SoC-Labs/MegaSoC-Project/docs/src/fpga_build.rst

*********************
FPGA Flow
*********************
