SoC-Labs/MegaSoC-Project/fpga/targets/arm_mps4/fpga_pinmap.xdc

# -----------------------------------------------------------------------------
# Purpose : Main timing constraints and pin list for MPS3
# -----------------------------------------------------------------------------

####################################################################################
# Pin Assigment
####################################################################################

set_property IOSTANDARD LVCMOS18 [get_ports AUD_BCKAD_R] 
set_property PACKAGE_PIN BB22 [get_ports AUD_BCKAD_R] 
set_property IOSTANDARD LVCMOS18 [get_ports AUD_BCKDA_R] 
set_property PACKAGE_PIN BA24 [get_ports AUD_BCKDA_R] 
set_property IOSTANDARD LVCMOS18 [get_ports AUD_DIN[1]] 
set_property PACKAGE_PIN BA25 [get_ports AUD_DIN[1]] 
set_property IOSTANDARD LVCMOS18 [get_ports AUD_DIN[2]] 
set_property PACKAGE_PIN BD21 [get_ports AUD_DIN[2]] 
set_property IOSTANDARD LVCMOS18 [get_ports AUD_DIN[3]] 
set_property PACKAGE_PIN BC21 [get_ports AUD_DIN[3]] 
set_property IOSTANDARD LVCMOS18 [get_ports AUD_DIN[4]] 
set_property PACKAGE_PIN BB23 [get_ports AUD_DIN[4]] 
set_property IOSTANDARD LVCMOS18 [get_ports AUD_DOUT[1]] 
set_property PACKAGE_PIN BB24 [get_ports AUD_DOUT[1]] 
set_property IOSTANDARD LVCMOS18 [get_ports AUD_DOUT[2]] 
set_property PACKAGE_PIN BF22 [get_ports AUD_DOUT[2]] 
set_property IOSTANDARD LVCMOS18 [get_ports AUD_DOUT[3]] 
set_property PACKAGE_PIN BE22 [get_ports AUD_DOUT[3]] 
set_property IOSTANDARD LVCMOS18 [get_ports AUD_LRCKAD_R] 
set_property PACKAGE_PIN BE23 [get_ports AUD_LRCKAD_R] 
set_property IOSTANDARD LVCMOS18 [get_ports AUD_LRCKDA_R] 
set_property PACKAGE_PIN BD23 [get_ports AUD_LRCKDA_R] 
set_property IOSTANDARD LVCMOS18 [get_ports AUD_RST] 
set_property PACKAGE_PIN BD22 [get_ports AUD_RST] 
set_property IOSTANDARD LVCMOS18 [get_ports AUD_SCKI_R] 
set_property PACKAGE_PIN BC23 [get_ports AUD_SCKI_R] 
set_property IOSTANDARD LVCMOS18 [get_ports AUD_SCL] 
set_property PACKAGE_PIN BF24 [get_ports AUD_SCL] 
set_property IOSTANDARD LVCMOS18 [get_ports AUD_SDA] 
set_property PACKAGE_PIN BE24 [get_ports AUD_SDA] 
set_property IOSTANDARD DIFF_HSTL_I_18  [get_ports B2B_CLKN[0]] 
set_property PACKAGE_PIN AN41 [get_ports B2B_CLKN[0]] 
set_property IOSTANDARD DIFF_HSTL_I_18  [get_ports B2B_CLKN[1]] 
set_property PACKAGE_PIN AK39 [get_ports B2B_CLKN[1]] 
set_property IOSTANDARD DIFF_HSTL_I_18  [get_ports B2B_CLKN[2]] 
set_property PACKAGE_PIN AF39 [get_ports B2B_CLKN[2]] 
set_property IOSTANDARD DIFF_HSTL_I_18  [get_ports B2B_CLKN[3]] 
set_property PACKAGE_PIN AB39 [get_ports B2B_CLKN[3]] 
set_property IOSTANDARD DIFF_HSTL_I_18  [get_ports B2B_CLKN[4]] 
set_property PACKAGE_PIN V39 [get_ports B2B_CLKN[4]] 
set_property IOSTANDARD DIFF_HSTL_I_18  [get_ports B2B_CLKN[5]] 
set_property PACKAGE_PIN R41 [get_ports B2B_CLKN[5]] 
set_property IOSTANDARD DIFF_HSTL_I_18  [get_ports B2B_CLKN[6]] 
set_property PACKAGE_PIN AC8 [get_ports B2B_CLKN[6]] 
set_property IOSTANDARD DIFF_HSTL_I_18  [get_ports B2B_CLKN[7]] 
set_property PACKAGE_PIN R8 [get_ports B2B_CLKN[7]] 
set_property IOSTANDARD DIFF_HSTL_I_18  [get_ports B2B_CLKN[8]] 
set_property PACKAGE_PIN L8 [get_ports B2B_CLKN[8]] 
set_property IOSTANDARD DIFF_HSTL_I_18  [get_ports B2B_CLKN[9]] 
set_property PACKAGE_PIN AE8 [get_ports B2B_CLKN[9]] 
set_property IOSTANDARD DIFF_HSTL_I_18  [get_ports B2B_CLKP[0]] 
set_property PACKAGE_PIN AN40 [get_ports B2B_CLKP[0]] 
set_property IOSTANDARD DIFF_HSTL_I_18  [get_ports B2B_CLKP[1]] 
set_property PACKAGE_PIN AK38 [get_ports B2B_CLKP[1]] 
set_property IOSTANDARD DIFF_HSTL_I_18  [get_ports B2B_CLKP[2]] 
set_property PACKAGE_PIN AF38 [get_ports B2B_CLKP[2]] 
set_property IOSTANDARD DIFF_HSTL_I_18  [get_ports B2B_CLKP[3]] 
set_property PACKAGE_PIN AB38 [get_ports B2B_CLKP[3]] 
set_property IOSTANDARD DIFF_HSTL_I_18  [get_ports B2B_CLKP[4]] 
set_property PACKAGE_PIN V38 [get_ports B2B_CLKP[4]] 
set_property IOSTANDARD DIFF_HSTL_I_18  [get_ports B2B_CLKP[5]] 
set_property PACKAGE_PIN R40 [get_ports B2B_CLKP[5]] 
set_property IOSTANDARD DIFF_HSTL_I_18  [get_ports B2B_CLKP[6]] 
set_property PACKAGE_PIN AC9 [get_ports B2B_CLKP[6]] 
set_property IOSTANDARD DIFF_HSTL_I_18  [get_ports B2B_CLKP[7]] 
set_property PACKAGE_PIN R9 [get_ports B2B_CLKP[7]] 
set_property IOSTANDARD DIFF_HSTL_I_18  [get_ports B2B_CLKP[8]] 
set_property PACKAGE_PIN L9 [get_ports B2B_CLKP[8]] 
set_property IOSTANDARD DIFF_HSTL_I_18  [get_ports B2B_CLKP[9]] 
set_property PACKAGE_PIN AE9 [get_ports B2B_CLKP[9]] 
set_property IOSTANDARD LVCMOS18 [get_ports CB_nPOR] 
set_property PACKAGE_PIN AJ13 [get_ports CB_nPOR] 
set_property IOSTANDARD LVCMOS18 [get_ports CB_nRST] 
set_property PACKAGE_PIN AL12 [get_ports CB_nRST] 
set_property IOSTANDARD LVCMOS18 [get_ports CB_RSVD_F[0]] 
set_property PACKAGE_PIN AL32 [get_ports CB_RSVD_F[0]] 
set_property IOSTANDARD LVCMOS18 [get_ports CB_RSVD_F[1]] 
set_property PACKAGE_PIN AL35 [get_ports CB_RSVD_F[1]] 
set_property IOSTANDARD LVCMOS18 [get_ports CB_RSVD_F[2]] 
set_property PACKAGE_PIN AL34 [get_ports CB_RSVD_F[2]] 
set_property IOSTANDARD LVCMOS18 [get_ports CB_RUN] 
set_property PACKAGE_PIN AK12 [get_ports CB_RUN] 
set_property IOSTANDARD LVCMOS18 [get_ports CFG_CLK] 
set_property PACKAGE_PIN G18 [get_ports CFG_CLK] 
set_property IOSTANDARD LVCMOS18 [get_ports CFG_DATAIN] 
set_property PACKAGE_PIN D20 [get_ports CFG_DATAIN] 
set_property IOSTANDARD LVCMOS18 [get_ports CFG_DATAOUT] 
set_property PACKAGE_PIN D19 [get_ports CFG_DATAOUT] 
set_property IOSTANDARD LVCMOS18 [get_ports CFG_LOAD] 
set_property PACKAGE_PIN D17 [get_ports CFG_LOAD] 
set_property IOSTANDARD LVCMOS18 [get_ports CFG_nRST] 
set_property PACKAGE_PIN D16 [get_ports CFG_nRST] 
set_property IOSTANDARD LVCMOS18 [get_ports CFG_WnR] 
set_property PACKAGE_PIN C20 [get_ports CFG_WnR] 
set_property IOSTANDARD LVDS [get_ports CLK_BIDIR_R_N[2]] 
set_property PACKAGE_PIN F31 [get_ports CLK_BIDIR_R_N[2]] 
set_property IOSTANDARD LVDS [get_ports CLK_BIDIR_R_N[3]] 
set_property PACKAGE_PIN H30 [get_ports CLK_BIDIR_R_N[3]] 
set_property IOSTANDARD LVDS [get_ports CLK_BIDIR_R_P[2]] 
set_property PACKAGE_PIN G31 [get_ports CLK_BIDIR_R_P[2]] 
set_property IOSTANDARD LVDS [get_ports CLK_BIDIR_R_P[3]] 
set_property PACKAGE_PIN H29 [get_ports CLK_BIDIR_R_P[3]] 
set_property IOSTANDARD LVDS [get_ports CLK_M2C_N[0]] 
set_property PACKAGE_PIN F30 [get_ports CLK_M2C_N[0]] 
set_property IOSTANDARD LVDS [get_ports CLK_M2C_N[1]] 
set_property PACKAGE_PIN P32 [get_ports CLK_M2C_N[1]] 
set_property IOSTANDARD LVDS [get_ports CLK_M2C_P[0]] 
set_property PACKAGE_PIN G30 [get_ports CLK_M2C_P[0]] 
set_property IOSTANDARD LVDS [get_ports CLK_M2C_P[1]] 
set_property PACKAGE_PIN R32 [get_ports CLK_M2C_P[1]] 
set_property IOSTANDARD LVCMOS18 [get_ports CS_nDET] 
set_property PACKAGE_PIN AK15 [get_ports CS_nDET] 
set_property IOSTANDARD LVCMOS18 [get_ports CS_nSRST] 
set_property PACKAGE_PIN AM14 [get_ports CS_nSRST] 
set_property IOSTANDARD LVCMOS18 [get_ports CS_nTRST] 
set_property PACKAGE_PIN AL14 [get_ports CS_nTRST] 
set_property IOSTANDARD LVCMOS18 [get_ports CS_T_CLKA_R] 
set_property PACKAGE_PIN AR15 [get_ports CS_T_CLKA_R] 
set_property IOSTANDARD LVCMOS18 [get_ports CS_T_CLKB_R] 
set_property PACKAGE_PIN AP15 [get_ports CS_T_CLKB_R] 
set_property IOSTANDARD LVCMOS18 [get_ports CS_T_CTL] 
set_property PACKAGE_PIN AN15 [get_ports CS_T_CTL] 
set_property IOSTANDARD LVCMOS18 [get_ports CS_T_D[0]] 
set_property PACKAGE_PIN AP16 [get_ports CS_T_D[0]] 
set_property IOSTANDARD LVCMOS18 [get_ports CS_T_D[1]] 
set_property PACKAGE_PIN AN16 [get_ports CS_T_D[1]] 
set_property IOSTANDARD LVCMOS18 [get_ports CS_T_D[10]] 
set_property PACKAGE_PIN AW16 [get_ports CS_T_D[10]] 
set_property IOSTANDARD LVCMOS18 [get_ports CS_T_D[11]] 
set_property PACKAGE_PIN AM16 [get_ports CS_T_D[11]] 
set_property IOSTANDARD LVCMOS18 [get_ports CS_T_D[12]] 
set_property PACKAGE_PIN AY12 [get_ports CS_T_D[12]] 
set_property IOSTANDARD LVCMOS18 [get_ports CS_T_D[13]] 
set_property PACKAGE_PIN AU13 [get_ports CS_T_D[13]] 
set_property IOSTANDARD LVCMOS18 [get_ports CS_T_D[14]] 
set_property PACKAGE_PIN AU14 [get_ports CS_T_D[14]] 
set_property IOSTANDARD LVCMOS18 [get_ports CS_T_D[15]] 
set_property PACKAGE_PIN AY14 [get_ports CS_T_D[15]] 
set_property IOSTANDARD LVCMOS18 [get_ports CS_T_D[16]] 
set_property PACKAGE_PIN AY15 [get_ports CS_T_D[16]] 
set_property IOSTANDARD LVCMOS18 [get_ports CS_T_D[17]] 
set_property PACKAGE_PIN AW15 [get_ports CS_T_D[17]] 
set_property IOSTANDARD LVCMOS18 [get_ports CS_T_D[18]] 
set_property PACKAGE_PIN AV15 [get_ports CS_T_D[18]] 
set_property IOSTANDARD LVCMOS18 [get_ports CS_T_D[19]] 
set_property PACKAGE_PIN AV16 [get_ports CS_T_D[19]] 
set_property IOSTANDARD LVCMOS18 [get_ports CS_T_D[2]] 
set_property PACKAGE_PIN AR12 [get_ports CS_T_D[2]] 
set_property IOSTANDARD LVCMOS18 [get_ports CS_T_D[20]] 
set_property PACKAGE_PIN AU16 [get_ports CS_T_D[20]] 
set_property IOSTANDARD LVCMOS18 [get_ports CS_T_D[21]] 
set_property PACKAGE_PIN AT15 [get_ports CS_T_D[21]] 
set_property IOSTANDARD LVCMOS18 [get_ports CS_T_D[22]] 
set_property PACKAGE_PIN AT16 [get_ports CS_T_D[22]] 
set_property IOSTANDARD LVCMOS18 [get_ports CS_T_D[23]] 
set_property PACKAGE_PIN AV13 [get_ports CS_T_D[23]] 
set_property IOSTANDARD LVCMOS18 [get_ports CS_T_D[24]] 
set_property PACKAGE_PIN AV11 [get_ports CS_T_D[24]] 
set_property IOSTANDARD LVCMOS18 [get_ports CS_T_D[25]] 
set_property PACKAGE_PIN AU11 [get_ports CS_T_D[25]] 
set_property IOSTANDARD LVCMOS18 [get_ports CS_T_D[26]] 
set_property PACKAGE_PIN AY13 [get_ports CS_T_D[26]] 
set_property IOSTANDARD LVCMOS18 [get_ports CS_T_D[27]] 
set_property PACKAGE_PIN AW13 [get_ports CS_T_D[27]] 
set_property IOSTANDARD LVCMOS18 [get_ports CS_T_D[28]] 
set_property PACKAGE_PIN AW10 [get_ports CS_T_D[28]] 
set_property IOSTANDARD LVCMOS18 [get_ports CS_T_D[29]] 
set_property PACKAGE_PIN AV10 [get_ports CS_T_D[29]] 
set_property IOSTANDARD LVCMOS18 [get_ports CS_T_D[3]] 
set_property PACKAGE_PIN AP12 [get_ports CS_T_D[3]] 
set_property IOSTANDARD LVCMOS18 [get_ports CS_T_D[30]] 
set_property PACKAGE_PIN AY10 [get_ports CS_T_D[30]] 
set_property IOSTANDARD LVCMOS18 [get_ports CS_T_D[31]] 
set_property PACKAGE_PIN AW11 [get_ports CS_T_D[31]] 
set_property IOSTANDARD LVCMOS18 [get_ports CS_T_D[4]] 
set_property PACKAGE_PIN AN13 [get_ports CS_T_D[4]] 
set_property IOSTANDARD LVCMOS18 [get_ports CS_T_D[5]] 
set_property PACKAGE_PIN AN14 [get_ports CS_T_D[5]] 
set_property IOSTANDARD LVCMOS18 [get_ports CS_T_D[6]] 
set_property PACKAGE_PIN AR13 [get_ports CS_T_D[6]] 
set_property IOSTANDARD LVCMOS18 [get_ports CS_T_D[7]] 
set_property PACKAGE_PIN AP13 [get_ports CS_T_D[7]] 
set_property IOSTANDARD LVCMOS18 [get_ports CS_T_D[8]] 
set_property PACKAGE_PIN AT14 [get_ports CS_T_D[8]] 
set_property IOSTANDARD LVCMOS18 [get_ports CS_T_D[9]] 
set_property PACKAGE_PIN AR14 [get_ports CS_T_D[9]] 
set_property IOSTANDARD LVCMOS18 [get_ports CS_TCK] 
set_property PACKAGE_PIN AV14 [get_ports CS_TCK] 
set_property IOSTANDARD LVCMOS18 [get_ports CS_TDI] 
set_property PACKAGE_PIN AW12 [get_ports CS_TDI] 
set_property IOSTANDARD LVCMOS18 [get_ports CS_TDO] 
set_property PACKAGE_PIN AU12 [get_ports CS_TDO] 
set_property IOSTANDARD LVCMOS18 [get_ports CS_TMS] 
set_property PACKAGE_PIN AT12 [get_ports CS_TMS] 
set_property IOSTANDARD MIPI_DPHY_DCI [get_ports CSI_0_DN[0]] 
set_property PACKAGE_PIN P22 [get_ports CSI_0_DN[0]] 
set_property IOSTANDARD MIPI_DPHY_DCI [get_ports CSI_0_DN[1]] 
set_property PACKAGE_PIN R23 [get_ports CSI_0_DN[1]] 
set_property IOSTANDARD MIPI_DPHY_DCI [get_ports CSI_0_DP[0]] 
set_property PACKAGE_PIN R22 [get_ports CSI_0_DP[0]] 
set_property IOSTANDARD MIPI_DPHY_DCI [get_ports CSI_0_DP[1]] 
set_property PACKAGE_PIN T23 [get_ports CSI_0_DP[1]] 
set_property IOSTANDARD MIPI_DPHY_DCI [get_ports CSI_1_DN[0]] 
set_property PACKAGE_PIN A23 [get_ports CSI_1_DN[0]] 
set_property IOSTANDARD MIPI_DPHY_DCI [get_ports CSI_1_DN[1]] 
set_property PACKAGE_PIN C23 [get_ports CSI_1_DN[1]] 
set_property IOSTANDARD MIPI_DPHY_DCI [get_ports CSI_1_DP[0]] 
set_property PACKAGE_PIN A24 [get_ports CSI_1_DP[0]] 
set_property IOSTANDARD MIPI_DPHY_DCI [get_ports CSI_1_DP[1]] 
set_property PACKAGE_PIN C24 [get_ports CSI_1_DP[1]] 
set_property IOSTANDARD MIPI_DPHY_DCI [get_ports CSI_2_DN[0]] 
set_property PACKAGE_PIN H22 [get_ports CSI_2_DN[0]] 
set_property IOSTANDARD MIPI_DPHY_DCI [get_ports CSI_2_DN[1]] 
set_property PACKAGE_PIN E22 [get_ports CSI_2_DN[1]] 
set_property IOSTANDARD MIPI_DPHY_DCI [get_ports CSI_2_DN[2]] 
set_property PACKAGE_PIN G23 [get_ports CSI_2_DN[2]] 
set_property IOSTANDARD MIPI_DPHY_DCI [get_ports CSI_2_DN[3]] 
set_property PACKAGE_PIN E21 [get_ports CSI_2_DN[3]] 
set_property IOSTANDARD MIPI_DPHY_DCI [get_ports CSI_2_DP[0]] 
set_property PACKAGE_PIN H23 [get_ports CSI_2_DP[0]] 
set_property IOSTANDARD MIPI_DPHY_DCI [get_ports CSI_2_DP[1]] 
set_property PACKAGE_PIN E23 [get_ports CSI_2_DP[1]] 
set_property IOSTANDARD MIPI_DPHY_DCI [get_ports CSI_2_DP[2]] 
set_property PACKAGE_PIN H24 [get_ports CSI_2_DP[2]] 
set_property IOSTANDARD MIPI_DPHY_DCI [get_ports CSI_2_DP[3]] 
set_property PACKAGE_PIN F21 [get_ports CSI_2_DP[3]] 
set_property IOSTANDARD MIPI_DPHY_DCI [get_ports CSI_CN[0]] 
set_property PACKAGE_PIN M22 [get_ports CSI_CN[0]] 
set_property IOSTANDARD MIPI_DPHY_DCI [get_ports CSI_CN[1]] 
set_property PACKAGE_PIN D24 [get_ports CSI_CN[1]] 
set_property IOSTANDARD MIPI_DPHY_DCI [get_ports CSI_CN[2]] 
set_property PACKAGE_PIN G21 [get_ports CSI_CN[2]] 
set_property IOSTANDARD MIPI_DPHY_DCI [get_ports CSI_CP[0]] 
set_property PACKAGE_PIN N22 [get_ports CSI_CP[0]] 
set_property IOSTANDARD MIPI_DPHY_DCI [get_ports CSI_CP[1]] 
set_property PACKAGE_PIN E24 [get_ports CSI_CP[1]] 
set_property IOSTANDARD MIPI_DPHY_DCI [get_ports CSI_CP[2]] 
set_property PACKAGE_PIN G22 [get_ports CSI_CP[2]] 
set_property IOSTANDARD LVCMOS18 [get_ports CSI_GP[0]] 
set_property PACKAGE_PIN A9 [get_ports CSI_GP[0]] 
set_property IOSTANDARD LVCMOS18 [get_ports CSI_GP[1]] 
set_property PACKAGE_PIN A8 [get_ports CSI_GP[1]] 
set_property IOSTANDARD LVCMOS18 [get_ports CSI_GP[2]] 
set_property PACKAGE_PIN A16 [get_ports CSI_GP[2]] 
set_property IOSTANDARD LVCMOS18 [get_ports CSI_GP[3]] 
set_property PACKAGE_PIN A15 [get_ports CSI_GP[3]] 
set_property IOSTANDARD LVCMOS18 [get_ports CSI_GP[4]] 
set_property PACKAGE_PIN A14 [get_ports CSI_GP[4]] 
set_property IOSTANDARD LVCMOS18 [get_ports CSI_GP[5]] 
set_property PACKAGE_PIN A13 [get_ports CSI_GP[5]] 
set_property IOSTANDARD LVCMOS18 [get_ports CSI_PWR_EN] 
set_property PACKAGE_PIN A10 [get_ports CSI_PWR_EN] 
set_property IOSTANDARD LVCMOS12 [get_ports CSI_PWRDN_B] 
set_property PACKAGE_PIN F24 [get_ports CSI_PWRDN_B] 
set_property IOSTANDARD LVCMOS12 [get_ports CSI_RESET_B] 
set_property PACKAGE_PIN F23 [get_ports CSI_RESET_B] 
set_property IOSTANDARD LVCMOS12 [get_ports CSI_SCL[0]] 
set_property PACKAGE_PIN J22 [get_ports CSI_SCL[0]] 
set_property IOSTANDARD LVCMOS12 [get_ports CSI_SCL[1]] 
set_property PACKAGE_PIN J21 [get_ports CSI_SCL[1]] 
set_property IOSTANDARD LVCMOS12 [get_ports CSI_SCL[2]] 
set_property PACKAGE_PIN C22 [get_ports CSI_SCL[2]] 
set_property IOSTANDARD LVCMOS12 [get_ports CSI_SDA[0]] 
set_property PACKAGE_PIN M21 [get_ports CSI_SDA[0]] 
set_property IOSTANDARD LVCMOS12 [get_ports CSI_SDA[1]] 
set_property PACKAGE_PIN M20 [get_ports CSI_SDA[1]] 
set_property IOSTANDARD LVCMOS12 [get_ports CSI_SDA[2]] 
set_property PACKAGE_PIN L21 [get_ports CSI_SDA[2]] 
set_property IOSTANDARD LVCMOS18 [get_ports CSI_XCLK] 
set_property PACKAGE_PIN A11 [get_ports CSI_XCLK] 
set_property IOSTANDARD SSTL12_DCI [get_ports DDR_A[0]] 
set_property PACKAGE_PIN BD32 [get_ports DDR_A[0]] 
set_property IOSTANDARD SSTL12_DCI [get_ports DDR_A[1]] 
set_property PACKAGE_PIN BE33 [get_ports DDR_A[1]] 
set_property IOSTANDARD SSTL12_DCI [get_ports DDR_A[10]] 
set_property PACKAGE_PIN BA32 [get_ports DDR_A[10]] 
set_property IOSTANDARD SSTL12_DCI [get_ports DDR_A[11]] 
set_property PACKAGE_PIN BB33 [get_ports DDR_A[11]] 
set_property IOSTANDARD SSTL12_DCI [get_ports DDR_A[12]] 
set_property PACKAGE_PIN BA30 [get_ports DDR_A[12]] 
set_property IOSTANDARD SSTL12_DCI [get_ports DDR_A[13]] 
set_property PACKAGE_PIN BA31 [get_ports DDR_A[13]] 
set_property IOSTANDARD SSTL12_DCI [get_ports DDR_A[2]] 
set_property PACKAGE_PIN BF30 [get_ports DDR_A[2]] 
set_property IOSTANDARD SSTL12_DCI [get_ports DDR_A[3]] 
set_property PACKAGE_PIN BF31 [get_ports DDR_A[3]] 
set_property IOSTANDARD SSTL12_DCI [get_ports DDR_A[4]] 
set_property PACKAGE_PIN BC33 [get_ports DDR_A[4]] 
set_property IOSTANDARD SSTL12_DCI [get_ports DDR_A[5]] 
set_property PACKAGE_PIN BD33 [get_ports DDR_A[5]] 
set_property IOSTANDARD SSTL12_DCI [get_ports DDR_A[6]] 
set_property PACKAGE_PIN BC31 [get_ports DDR_A[6]] 
set_property IOSTANDARD SSTL12_DCI [get_ports DDR_A[7]] 
set_property PACKAGE_PIN BD31 [get_ports DDR_A[7]] 
set_property IOSTANDARD SSTL12_DCI [get_ports DDR_A[8]] 
set_property PACKAGE_PIN BB31 [get_ports DDR_A[8]] 
set_property IOSTANDARD SSTL12_DCI [get_ports DDR_A[9]] 
set_property PACKAGE_PIN BB32 [get_ports DDR_A[9]] 
set_property IOSTANDARD SSTL12_DCI [get_ports DDR_BA[0]] 
set_property PACKAGE_PIN AY33 [get_ports DDR_BA[0]] 
set_property IOSTANDARD SSTL12_DCI [get_ports DDR_BA[1]] 
set_property PACKAGE_PIN AV33 [get_ports DDR_BA[1]] 
set_property IOSTANDARD SSTL12_DCI [get_ports DDR_BG[0]] 
set_property PACKAGE_PIN AW33 [get_ports DDR_BG[0]] 
set_property IOSTANDARD SSTL12_DCI [get_ports DDR_BG[1]] 
set_property PACKAGE_PIN AV30 [get_ports DDR_BG[1]] 
set_property IOSTANDARD LVCMOS12 [get_ports DDR_CHIPID[0]] 
set_property PACKAGE_PIN AR30 [get_ports DDR_CHIPID[0]] 
set_property IOSTANDARD LVCMOS12 [get_ports DDR_CHIPID[1]] 
set_property PACKAGE_PIN AR32 [get_ports DDR_CHIPID[1]] 
set_property IOSTANDARD DIFF_SSTL12_DCI [get_ports DDR_CK_N[0]] 
set_property PACKAGE_PIN BF32 [get_ports DDR_CK_N[0]] 
set_property IOSTANDARD DIFF_SSTL12_DCI [get_ports DDR_CK_N[1]] 
set_property PACKAGE_PIN BE30 [get_ports DDR_CK_N[1]] 
set_property IOSTANDARD DIFF_SSTL12_DCI [get_ports DDR_CK_P[0]] 
set_property PACKAGE_PIN BE32 [get_ports DDR_CK_P[0]] 
set_property IOSTANDARD DIFF_SSTL12_DCI [get_ports DDR_CK_P[1]] 
set_property PACKAGE_PIN BD30 [get_ports DDR_CK_P[1]] 
set_property IOSTANDARD SSTL12_DCI [get_ports DDR_CKE[0]] 
set_property PACKAGE_PIN AU34 [get_ports DDR_CKE[0]] 
set_property IOSTANDARD SSTL12_DCI [get_ports DDR_CKE[1]] 
set_property PACKAGE_PIN AU29 [get_ports DDR_CKE[1]] 
set_property IOSTANDARD POD12_DCI [get_ports DDR_DM[0]] 
set_property PACKAGE_PIN AV35 [get_ports DDR_DM[0]] 
set_property IOSTANDARD POD12_DCI [get_ports DDR_DM[1]] 
set_property PACKAGE_PIN AY37 [get_ports DDR_DM[1]] 
set_property IOSTANDARD POD12_DCI [get_ports DDR_DM[2]] 
set_property PACKAGE_PIN BE40 [get_ports DDR_DM[2]] 
set_property IOSTANDARD POD12_DCI [get_ports DDR_DM[3]] 
set_property PACKAGE_PIN BC34 [get_ports DDR_DM[3]] 
set_property IOSTANDARD POD12_DCI [get_ports DDR_DM[4]] 
set_property PACKAGE_PIN BE29 [get_ports DDR_DM[4]] 
set_property IOSTANDARD POD12_DCI [get_ports DDR_DM[5]] 
set_property PACKAGE_PIN BA29 [get_ports DDR_DM[5]] 
set_property IOSTANDARD POD12_DCI [get_ports DDR_DM[6]] 
set_property PACKAGE_PIN AW26 [get_ports DDR_DM[6]] 
set_property IOSTANDARD POD12_DCI [get_ports DDR_DM[7]] 
set_property PACKAGE_PIN AR27 [get_ports DDR_DM[7]] 
set_property IOSTANDARD POD12_DCI [get_ports DDR_DQ[0]] 
set_property PACKAGE_PIN AU38 [get_ports DDR_DQ[0]] 
set_property IOSTANDARD POD12_DCI [get_ports DDR_DQ[1]] 
set_property PACKAGE_PIN AU39 [get_ports DDR_DQ[1]] 
set_property IOSTANDARD POD12_DCI [get_ports DDR_DQ[10]] 
set_property PACKAGE_PIN BA39 [get_ports DDR_DQ[10]] 
set_property IOSTANDARD POD12_DCI [get_ports DDR_DQ[11]] 
set_property PACKAGE_PIN AY38 [get_ports DDR_DQ[11]] 
set_property IOSTANDARD POD12_DCI [get_ports DDR_DQ[12]] 
set_property PACKAGE_PIN AW40 [get_ports DDR_DQ[12]] 
set_property IOSTANDARD POD12_DCI [get_ports DDR_DQ[13]] 
set_property PACKAGE_PIN AY40 [get_ports DDR_DQ[13]] 
set_property IOSTANDARD POD12_DCI [get_ports DDR_DQ[14]] 
set_property PACKAGE_PIN BA40 [get_ports DDR_DQ[14]] 
set_property IOSTANDARD POD12_DCI [get_ports DDR_DQ[15]] 
set_property PACKAGE_PIN AY39 [get_ports DDR_DQ[15]] 
set_property IOSTANDARD POD12_DCI [get_ports DDR_DQ[16]] 
set_property PACKAGE_PIN BB38 [get_ports DDR_DQ[16]] 
set_property IOSTANDARD POD12_DCI [get_ports DDR_DQ[17]] 
set_property PACKAGE_PIN BC38 [get_ports DDR_DQ[17]] 
set_property IOSTANDARD POD12_DCI [get_ports DDR_DQ[18]] 
set_property PACKAGE_PIN BC39 [get_ports DDR_DQ[18]] 
set_property IOSTANDARD POD12_DCI [get_ports DDR_DQ[19]] 
set_property PACKAGE_PIN BD40 [get_ports DDR_DQ[19]] 
set_property IOSTANDARD POD12_DCI [get_ports DDR_DQ[2]] 
set_property PACKAGE_PIN AU40 [get_ports DDR_DQ[2]] 
set_property IOSTANDARD POD12_DCI [get_ports DDR_DQ[20]] 
set_property PACKAGE_PIN BD37 [get_ports DDR_DQ[20]] 
set_property IOSTANDARD POD12_DCI [get_ports DDR_DQ[21]] 
set_property PACKAGE_PIN BB39 [get_ports DDR_DQ[21]] 
set_property IOSTANDARD POD12_DCI [get_ports DDR_DQ[22]] 
set_property PACKAGE_PIN BE38 [get_ports DDR_DQ[22]] 
set_property IOSTANDARD POD12_DCI [get_ports DDR_DQ[23]] 
set_property PACKAGE_PIN BD38 [get_ports DDR_DQ[23]] 
set_property IOSTANDARD POD12_DCI [get_ports DDR_DQ[24]] 
set_property PACKAGE_PIN BE34 [get_ports DDR_DQ[24]] 
set_property IOSTANDARD POD12_DCI [get_ports DDR_DQ[25]] 
set_property PACKAGE_PIN BF34 [get_ports DDR_DQ[25]] 
set_property IOSTANDARD POD12_DCI [get_ports DDR_DQ[26]] 
set_property PACKAGE_PIN BC35 [get_ports DDR_DQ[26]] 
set_property IOSTANDARD POD12_DCI [get_ports DDR_DQ[27]] 
set_property PACKAGE_PIN BC36 [get_ports DDR_DQ[27]] 
set_property IOSTANDARD POD12_DCI [get_ports DDR_DQ[28]] 
set_property PACKAGE_PIN BD36 [get_ports DDR_DQ[28]] 
set_property IOSTANDARD POD12_DCI [get_ports DDR_DQ[29]] 
set_property PACKAGE_PIN BE37 [get_ports DDR_DQ[29]] 
set_property IOSTANDARD POD12_DCI [get_ports DDR_DQ[3]] 
set_property PACKAGE_PIN AV40 [get_ports DDR_DQ[3]] 
set_property IOSTANDARD POD12_DCI [get_ports DDR_DQ[30]] 
set_property PACKAGE_PIN BF36 [get_ports DDR_DQ[30]] 
set_property IOSTANDARD POD12_DCI [get_ports DDR_DQ[31]] 
set_property PACKAGE_PIN BF37 [get_ports DDR_DQ[31]] 
set_property IOSTANDARD POD12_DCI [get_ports DDR_DQ[32]] 
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
set_property PACKAGE_PIN AW38 [get_ports DDR_DQS_N[0]] 
set_property IOSTANDARD DIFF_POD12_DCI [get_ports DDR_DQS_N[1]] 
set_property PACKAGE_PIN BA36 [get_ports DDR_DQS_N[1]] 
set_property IOSTANDARD DIFF_POD12_DCI [get_ports DDR_DQS_N[2]] 
set_property PACKAGE_PIN BF39 [get_ports DDR_DQS_N[2]] 
set_property IOSTANDARD DIFF_POD12_DCI [get_ports DDR_DQS_N[3]] 
set_property PACKAGE_PIN BF35 [get_ports DDR_DQS_N[3]] 
set_property IOSTANDARD DIFF_POD12_DCI [get_ports DDR_DQS_N[4]] 
set_property PACKAGE_PIN BF25 [get_ports DDR_DQS_N[4]] 
set_property IOSTANDARD DIFF_POD12_DCI [get_ports DDR_DQS_N[5]] 
set_property PACKAGE_PIN BB26 [get_ports DDR_DQS_N[5]] 
set_property IOSTANDARD DIFF_POD12_DCI [get_ports DDR_DQS_N[6]] 
set_property PACKAGE_PIN AT27 [get_ports DDR_DQS_N[6]] 
set_property IOSTANDARD DIFF_POD12_DCI [get_ports DDR_DQS_N[7]] 
set_property PACKAGE_PIN AN28 [get_ports DDR_DQS_N[7]] 
set_property IOSTANDARD DIFF_POD12_DCI [get_ports DDR_DQS_P[0]] 
set_property PACKAGE_PIN AW37 [get_ports DDR_DQS_P[0]] 
set_property IOSTANDARD DIFF_POD12_DCI [get_ports DDR_DQS_P[1]] 
set_property PACKAGE_PIN BA35 [get_ports DDR_DQS_P[1]] 
set_property IOSTANDARD DIFF_POD12_DCI [get_ports DDR_DQS_P[2]] 
set_property PACKAGE_PIN BE39 [get_ports DDR_DQS_P[2]] 
set_property IOSTANDARD DIFF_POD12_DCI [get_ports DDR_DQS_P[3]] 
set_property PACKAGE_PIN BE35 [get_ports DDR_DQS_P[3]] 
set_property IOSTANDARD DIFF_POD12_DCI [get_ports DDR_DQS_P[4]] 
set_property PACKAGE_PIN BE25 [get_ports DDR_DQS_P[4]] 
set_property IOSTANDARD DIFF_POD12_DCI [get_ports DDR_DQS_P[5]] 
set_property PACKAGE_PIN BA26 [get_ports DDR_DQS_P[5]] 
set_property IOSTANDARD DIFF_POD12_DCI [get_ports DDR_DQS_P[6]] 
set_property PACKAGE_PIN AT26 [get_ports DDR_DQS_P[6]] 
set_property IOSTANDARD DIFF_POD12_DCI [get_ports DDR_DQS_P[7]] 
set_property PACKAGE_PIN AM28 [get_ports DDR_DQS_P[7]] 
set_property IOSTANDARD SSTL12_DCI [get_ports DDR_nACT] 
set_property PACKAGE_PIN AU32 [get_ports DDR_nACT] 
set_property IOSTANDARD LVCMOS12 [get_ports DDR_nALERT] 
set_property PACKAGE_PIN AT34 [get_ports DDR_nALERT] 
set_property IOSTANDARD SSTL12_DCI [get_ports DDR_nCAS_A15] 
set_property PACKAGE_PIN BA34 [get_ports DDR_nCAS_A15] 
set_property IOSTANDARD SSTL12_DCI [get_ports DDR_nCS[0]] 
set_property PACKAGE_PIN AW30 [get_ports DDR_nCS[0]] 
set_property IOSTANDARD SSTL12_DCI [get_ports DDR_nCS[1]] 
set_property PACKAGE_PIN AU33 [get_ports DDR_nCS[1]] 
set_property IOSTANDARD LVCMOS12 [get_ports DDR_nEVENT] 
set_property PACKAGE_PIN AR29 [get_ports DDR_nEVENT] 
set_property IOSTANDARD SSTL12_DCI [get_ports DDR_nRAS_A16] 
set_property PACKAGE_PIN AY32 [get_ports DDR_nRAS_A16] 
set_property IOSTANDARD LVCMOS12 [get_ports DDR_nRESET] 
set_property PACKAGE_PIN AU31 [get_ports DDR_nRESET] 
set_property IOSTANDARD SSTL12_DCI [get_ports DDR_nWE_A14] 
set_property PACKAGE_PIN AY34 [get_ports DDR_nWE_A14] 
set_property IOSTANDARD SSTL12_DCI [get_ports DDR_ODT[0]] 
set_property PACKAGE_PIN AV29 [get_ports DDR_ODT[0]] 
set_property IOSTANDARD SSTL12_DCI [get_ports DDR_ODT[1]] 
set_property PACKAGE_PIN AT31 [get_ports DDR_ODT[1]] 
set_property IOSTANDARD LVCMOS12 [get_ports DDR_PARITY] 
set_property PACKAGE_PIN AT30 [get_ports DDR_PARITY] 
set_property IOSTANDARD DIFF_SSTL12 [get_ports DDR_REFCLKN] 
set_property PACKAGE_PIN AW32 [get_ports DDR_REFCLKN] 
set_property IOSTANDARD DIFF_SSTL12 [get_ports DDR_REFCLKP] 
set_property PACKAGE_PIN AW31 [get_ports DDR_REFCLKP] 
set_property IOSTANDARD LVCMOS12 [get_ports DDR_SCL] 
set_property PACKAGE_PIN AT29 [get_ports DDR_SCL] 
set_property IOSTANDARD LVCMOS12 [get_ports DDR_SDA] 
set_property PACKAGE_PIN AT32 [get_ports DDR_SDA] 
set_property IOSTANDARD DIFF_HSTL_I_18  [get_ports DP_C2M_N[0]] 
set_property PACKAGE_PIN BE4 [get_ports DP_C2M_N[0]] 
set_property IOSTANDARD DIFF_HSTL_I_18  [get_ports DP_C2M_N[1]] 
set_property PACKAGE_PIN BC4 [get_ports DP_C2M_N[1]] 
set_property IOSTANDARD DIFF_HSTL_I_18  [get_ports DP_C2M_N[2]] 
set_property PACKAGE_PIN BA4 [get_ports DP_C2M_N[2]] 
set_property IOSTANDARD DIFF_HSTL_I_18  [get_ports DP_C2M_N[3]] 
set_property PACKAGE_PIN AW4 [get_ports DP_C2M_N[3]] 
set_property IOSTANDARD DIFF_HSTL_I_18  [get_ports DP_C2M_N[4]] 
set_property PACKAGE_PIN AT6 [get_ports DP_C2M_N[4]] 
set_property IOSTANDARD DIFF_HSTL_I_18  [get_ports DP_C2M_N[5]] 
set_property PACKAGE_PIN AP6 [get_ports DP_C2M_N[5]] 
set_property IOSTANDARD DIFF_HSTL_I_18  [get_ports DP_C2M_N[6]] 
set_property PACKAGE_PIN AR4 [get_ports DP_C2M_N[6]] 
set_property IOSTANDARD DIFF_HSTL_I_18  [get_ports DP_C2M_N[7]] 
set_property PACKAGE_PIN AU4 [get_ports DP_C2M_N[7]] 
set_property IOSTANDARD DIFF_HSTL_I_18  [get_ports DP_C2M_N[8]] 
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
set_property IOSTANDARD MIPI_DPHY_DCI [get_ports DSI_DP[0]] 
set_property PACKAGE_PIN N23 [get_ports DSI_DP[0]] 
set_property IOSTANDARD MIPI_DPHY_DCI [get_ports DSI_DP[1]] 
set_property PACKAGE_PIN R21 [get_ports DSI_DP[1]] 
set_property IOSTANDARD LVCMOS12 [get_ports DSI_SCL] 
set_property PACKAGE_PIN J24 [get_ports DSI_SCL] 
set_property IOSTANDARD LVCMOS12 [get_ports DSI_SDA] 
set_property PACKAGE_PIN B23 [get_ports DSI_SDA] 
set_property IOSTANDARD LVCMOS18 [get_ports DVI_CSCL] 
set_property PACKAGE_PIN AT37 [get_ports DVI_CSCL] 
set_property IOSTANDARD LVCMOS18 [get_ports DVI_CSDA] 
set_property PACKAGE_PIN AT39 [get_ports DVI_CSDA] 
set_property IOSTANDARD LVCMOS18 [get_ports DVI_INT] 
set_property PACKAGE_PIN AT40 [get_ports DVI_INT] 
set_property IOSTANDARD LVCMOS18 [get_ports FIFO_CLK] 
set_property PACKAGE_PIN AY9 [get_ports FIFO_CLK] 
set_property IOSTANDARD LVCMOS18 [get_ports FIFO_D[0]] 
set_property PACKAGE_PIN BC8 [get_ports FIFO_D[0]] 
set_property IOSTANDARD LVCMOS18 [get_ports FIFO_D[1]] 
set_property PACKAGE_PIN BC9 [get_ports FIFO_D[1]] 
set_property IOSTANDARD LVCMOS18 [get_ports FIFO_D[10]] 
set_property PACKAGE_PIN BD7 [get_ports FIFO_D[10]] 
set_property IOSTANDARD LVCMOS18 [get_ports FIFO_D[11]] 
set_property PACKAGE_PIN BD8 [get_ports FIFO_D[11]] 
set_property IOSTANDARD LVCMOS18 [get_ports FIFO_D[12]] 
set_property PACKAGE_PIN BF15 [get_ports FIFO_D[12]] 
set_property IOSTANDARD LVCMOS18 [get_ports FIFO_D[13]] 
set_property PACKAGE_PIN BE15 [get_ports FIFO_D[13]] 
set_property IOSTANDARD LVCMOS18 [get_ports FIFO_D[14]] 
set_property PACKAGE_PIN BF14 [get_ports FIFO_D[14]] 
set_property IOSTANDARD LVCMOS18 [get_ports FIFO_D[15]] 
set_property PACKAGE_PIN BE14 [get_ports FIFO_D[15]] 
set_property IOSTANDARD LVCMOS18 [get_ports FIFO_D[2]] 
set_property PACKAGE_PIN BD10 [get_ports FIFO_D[2]] 
set_property IOSTANDARD LVCMOS18 [get_ports FIFO_D[3]] 
set_property PACKAGE_PIN BC10 [get_ports FIFO_D[3]] 
set_property IOSTANDARD LVCMOS18 [get_ports FIFO_D[4]] 
set_property PACKAGE_PIN BF9 [get_ports FIFO_D[4]] 
set_property IOSTANDARD LVCMOS18 [get_ports FIFO_D[5]] 
set_property PACKAGE_PIN BF10 [get_ports FIFO_D[5]] 
set_property IOSTANDARD LVCMOS18 [get_ports FIFO_D[6]] 
set_property PACKAGE_PIN BE9 [get_ports FIFO_D[6]] 
set_property IOSTANDARD LVCMOS18 [get_ports FIFO_D[7]] 
set_property PACKAGE_PIN BE10 [get_ports FIFO_D[7]] 
set_property IOSTANDARD LVCMOS18 [get_ports FIFO_D[8]] 
set_property PACKAGE_PIN BE7 [get_ports FIFO_D[8]] 
set_property IOSTANDARD LVCMOS18 [get_ports FIFO_D[9]] 
set_property PACKAGE_PIN BE8 [get_ports FIFO_D[9]] 
set_property IOSTANDARD LVCMOS18 [get_ports FIFO_NBE[0]] 
set_property PACKAGE_PIN BE13 [get_ports FIFO_NBE[0]] 
set_property IOSTANDARD LVCMOS18 [get_ports FIFO_NBE[1]] 
set_property PACKAGE_PIN BD13 [get_ports FIFO_NBE[1]] 
set_property IOSTANDARD LVCMOS18 [get_ports FIFO_NOE] 
set_property PACKAGE_PIN BD11 [get_ports FIFO_NOE] 
set_property IOSTANDARD LVCMOS18 [get_ports FIFO_NRD] 
set_property PACKAGE_PIN BC11 [get_ports FIFO_NRD] 
set_property IOSTANDARD LVCMOS18 [get_ports FIFO_NRXF] 
set_property PACKAGE_PIN BF11 [get_ports FIFO_NRXF] 
set_property IOSTANDARD LVCMOS18 [get_ports FIFO_NTXE] 
set_property PACKAGE_PIN BF12 [get_ports FIFO_NTXE] 
set_property IOSTANDARD LVCMOS18 [get_ports FIFO_NWAK] 
set_property PACKAGE_PIN BE12 [get_ports FIFO_NWAK] 
set_property IOSTANDARD LVCMOS18 [get_ports FIFO_nWR] 
set_property PACKAGE_PIN BD12 [get_ports FIFO_nWR] 
set_property IOSTANDARD LVCMOS18 [get_ports FMC_CLK_DIR] 
set_property PACKAGE_PIN AL36 [get_ports FMC_CLK_DIR] 
set_property IOSTANDARD LVCMOS18 [get_ports FMC_nPRSNT] 
set_property PACKAGE_PIN AK35 [get_ports FMC_nPRSNT] 
set_property IOSTANDARD DIFF_HSTL_I_18  [get_ports GBTCLK_M2C_N[0]] 
set_property PACKAGE_PIN AL8 [get_ports GBTCLK_M2C_N[0]] 
set_property IOSTANDARD DIFF_HSTL_I_18  [get_ports GBTCLK_M2C_N[1]] 
set_property PACKAGE_PIN AR8 [get_ports GBTCLK_M2C_N[1]] 
set_property IOSTANDARD DIFF_HSTL_I_18  [get_ports GBTCLK_M2C_P[0]] 
set_property PACKAGE_PIN AL9 [get_ports GBTCLK_M2C_P[0]] 
set_property IOSTANDARD DIFF_HSTL_I_18  [get_ports GBTCLK_M2C_P[1]] 
set_property PACKAGE_PIN AR9 [get_ports GBTCLK_M2C_P[1]] 
set_property IOSTANDARD LVDS [get_ports HA_N[0]] 
set_property PACKAGE_PIN P36 [get_ports HA_N[0]] 
set_property IOSTANDARD LVDS [get_ports HA_N[1]] 
set_property PACKAGE_PIN P34 [get_ports HA_N[1]] 
set_property IOSTANDARD LVDS [get_ports HA_N[10]] 
set_property PACKAGE_PIN L30 [get_ports HA_N[10]] 
set_property IOSTANDARD LVDS [get_ports HA_N[11]] 
set_property PACKAGE_PIN J32 [get_ports HA_N[11]] 
set_property IOSTANDARD LVDS [get_ports HA_N[12]] 
set_property PACKAGE_PIN J30 [get_ports HA_N[12]] 
set_property IOSTANDARD LVDS [get_ports HA_N[13]] 
set_property PACKAGE_PIN J31 [get_ports HA_N[13]] 
set_property IOSTANDARD LVDS [get_ports HA_N[14]] 
set_property PACKAGE_PIN M30 [get_ports HA_N[14]] 
set_property IOSTANDARD LVDS [get_ports HA_N[15]] 
set_property PACKAGE_PIN N29 [get_ports HA_N[15]] 
set_property IOSTANDARD LVDS [get_ports HA_N[16]] 
set_property PACKAGE_PIN L31 [get_ports HA_N[16]] 
set_property IOSTANDARD LVDS [get_ports HA_N[17]] 
set_property PACKAGE_PIN R33 [get_ports HA_N[17]] 
set_property IOSTANDARD LVDS [get_ports HA_N[18]] 
set_property PACKAGE_PIN T36 [get_ports HA_N[18]] 
set_property IOSTANDARD LVDS [get_ports HA_N[19]] 
set_property PACKAGE_PIN R29 [get_ports HA_N[19]] 
set_property IOSTANDARD LVDS [get_ports HA_N[2]] 
set_property PACKAGE_PIN N37 [get_ports HA_N[2]] 
set_property IOSTANDARD LVDS [get_ports HA_N[20]] 
set_property PACKAGE_PIN P30 [get_ports HA_N[20]] 
set_property IOSTANDARD LVDS [get_ports HA_N[21]] 
set_property PACKAGE_PIN W34 [get_ports HA_N[21]] 
set_property IOSTANDARD LVDS [get_ports HA_N[22]] 
set_property PACKAGE_PIN W31 [get_ports HA_N[22]] 
set_property IOSTANDARD LVDS [get_ports HA_N[23]] 
set_property PACKAGE_PIN W32 [get_ports HA_N[23]] 
set_property IOSTANDARD LVDS [get_ports HA_N[3]] 
set_property PACKAGE_PIN M38 [get_ports HA_N[3]] 
set_property IOSTANDARD LVDS [get_ports HA_N[4]] 
set_property PACKAGE_PIN L36 [get_ports HA_N[4]] 
set_property IOSTANDARD LVDS [get_ports HA_N[5]] 
set_property PACKAGE_PIN L35 [get_ports HA_N[5]] 
set_property IOSTANDARD LVDS [get_ports HA_N[6]] 
set_property PACKAGE_PIN N35 [get_ports HA_N[6]] 
set_property IOSTANDARD LVDS [get_ports HA_N[7]] 
set_property PACKAGE_PIN L38 [get_ports HA_N[7]] 
set_property IOSTANDARD LVDS [get_ports HA_N[8]] 
set_property PACKAGE_PIN C33 [get_ports HA_N[8]] 
set_property IOSTANDARD LVDS [get_ports HA_N[9]] 
set_property PACKAGE_PIN K34 [get_ports HA_N[9]] 
set_property IOSTANDARD LVDS [get_ports HA_P[0]] 
set_property PACKAGE_PIN P35 [get_ports HA_P[0]] 
set_property IOSTANDARD LVDS [get_ports HA_P[1]] 
set_property PACKAGE_PIN R34 [get_ports HA_P[1]] 
set_property IOSTANDARD LVDS [get_ports HA_P[10]] 
set_property PACKAGE_PIN L29 [get_ports HA_P[10]] 
set_property IOSTANDARD LVDS [get_ports HA_P[11]] 
set_property PACKAGE_PIN K32 [get_ports HA_P[11]] 
set_property IOSTANDARD LVDS [get_ports HA_P[12]] 
set_property PACKAGE_PIN J29 [get_ports HA_P[12]] 
set_property IOSTANDARD LVDS [get_ports HA_P[13]] 
set_property PACKAGE_PIN K31 [get_ports HA_P[13]] 
set_property IOSTANDARD LVDS [get_ports HA_P[14]] 
set_property PACKAGE_PIN N30 [get_ports HA_P[14]] 
set_property IOSTANDARD LVDS [get_ports HA_P[15]] 
set_property PACKAGE_PIN N28 [get_ports HA_P[15]] 
set_property IOSTANDARD LVDS [get_ports HA_P[16]] 
set_property PACKAGE_PIN M31 [get_ports HA_P[16]] 
set_property IOSTANDARD LVDS [get_ports HA_P[17]] 
set_property PACKAGE_PIN T33 [get_ports HA_P[17]] 
set_property IOSTANDARD LVDS [get_ports HA_P[18]] 
set_property PACKAGE_PIN U35 [get_ports HA_P[18]] 
set_property IOSTANDARD LVDS [get_ports HA_P[19]] 
set_property PACKAGE_PIN R28 [get_ports HA_P[19]] 
set_property IOSTANDARD LVDS [get_ports HA_P[2]] 
set_property PACKAGE_PIN P37 [get_ports HA_P[2]] 
set_property IOSTANDARD LVDS [get_ports HA_P[20]] 
set_property PACKAGE_PIN P29 [get_ports HA_P[20]] 
set_property IOSTANDARD LVDS [get_ports HA_P[21]] 
set_property PACKAGE_PIN Y34 [get_ports HA_P[21]] 
set_property IOSTANDARD LVDS [get_ports HA_P[22]] 
set_property PACKAGE_PIN Y31 [get_ports HA_P[22]] 
set_property IOSTANDARD LVDS [get_ports HA_P[23]] 
set_property PACKAGE_PIN Y32 [get_ports HA_P[23]] 
set_property IOSTANDARD LVDS [get_ports HA_P[3]] 
set_property PACKAGE_PIN N38 [get_ports HA_P[3]] 
set_property IOSTANDARD LVDS [get_ports HA_P[4]] 
set_property PACKAGE_PIN M36 [get_ports HA_P[4]] 
set_property IOSTANDARD LVDS [get_ports HA_P[5]] 
set_property PACKAGE_PIN M35 [get_ports HA_P[5]] 
set_property IOSTANDARD LVDS [get_ports HA_P[6]] 
set_property PACKAGE_PIN N34 [get_ports HA_P[6]] 
set_property IOSTANDARD LVDS [get_ports HA_P[7]] 
set_property PACKAGE_PIN M37 [get_ports HA_P[7]] 
set_property IOSTANDARD LVDS [get_ports HA_P[8]] 
set_property PACKAGE_PIN C32 [get_ports HA_P[8]] 
set_property IOSTANDARD LVDS [get_ports HA_P[9]] 
set_property PACKAGE_PIN L34 [get_ports HA_P[9]] 
set_property IOSTANDARD LVDS [get_ports HB_N[0]] 
set_property PACKAGE_PIN F26 [get_ports HB_N[0]] 
set_property IOSTANDARD LVDS [get_ports HB_N[1]] 
set_property PACKAGE_PIN C28 [get_ports HB_N[1]] 
set_property IOSTANDARD LVDS [get_ports HB_N[10]] 
set_property PACKAGE_PIN L26 [get_ports HB_N[10]] 
set_property IOSTANDARD LVDS [get_ports HB_N[11]] 
set_property PACKAGE_PIN L25 [get_ports HB_N[11]] 
set_property IOSTANDARD LVDS [get_ports HB_N[12]] 
set_property PACKAGE_PIN N25 [get_ports HB_N[12]] 
set_property IOSTANDARD LVDS [get_ports HB_N[13]] 
set_property PACKAGE_PIN N24 [get_ports HB_N[13]] 
set_property IOSTANDARD LVDS [get_ports HB_N[14]] 
set_property PACKAGE_PIN P27 [get_ports HB_N[14]] 
set_property IOSTANDARD LVDS [get_ports HB_N[15]] 
set_property PACKAGE_PIN R24 [get_ports HB_N[15]] 
set_property IOSTANDARD LVDS [get_ports HB_N[16]] 
set_property PACKAGE_PIN R26 [get_ports HB_N[16]] 
set_property IOSTANDARD LVDS [get_ports HB_N[17]] 
set_property PACKAGE_PIN J27 [get_ports HB_N[17]] 
set_property IOSTANDARD LVDS [get_ports HB_N[18]] 
set_property PACKAGE_PIN P31 [get_ports HB_N[18]] 
set_property IOSTANDARD LVDS [get_ports HB_N[19]] 
set_property PACKAGE_PIN K28 [get_ports HB_N[19]] 
set_property IOSTANDARD LVDS [get_ports HB_N[2]] 
set_property PACKAGE_PIN B27 [get_ports HB_N[2]] 
set_property IOSTANDARD LVDS [get_ports HB_N[20]] 
set_property PACKAGE_PIN M32 [get_ports HB_N[20]] 
set_property IOSTANDARD LVDS [get_ports HB_N[21]] 
set_property PACKAGE_PIN M28 [get_ports HB_N[21]] 
set_property IOSTANDARD LVDS [get_ports HB_N[3]] 
set_property PACKAGE_PIN B25 [get_ports HB_N[3]] 
set_property IOSTANDARD LVDS [get_ports HB_N[4]] 
set_property PACKAGE_PIN E28 [get_ports HB_N[4]] 
set_property IOSTANDARD LVDS [get_ports HB_N[5]] 
set_property PACKAGE_PIN F25 [get_ports HB_N[5]] 
set_property IOSTANDARD LVDS [get_ports HB_N[6]] 
set_property PACKAGE_PIN J26 [get_ports HB_N[6]] 
set_property IOSTANDARD LVDS [get_ports HB_N[7]] 
set_property PACKAGE_PIN D26 [get_ports HB_N[7]] 
set_property IOSTANDARD LVDS [get_ports HB_N[8]] 
set_property PACKAGE_PIN E27 [get_ports HB_N[8]] 
set_property IOSTANDARD LVDS [get_ports HB_N[9]] 
set_property PACKAGE_PIN G28 [get_ports HB_N[9]] 
set_property IOSTANDARD LVDS [get_ports HB_P[0]] 
set_property PACKAGE_PIN G26 [get_ports HB_P[0]] 
set_property IOSTANDARD LVDS [get_ports HB_P[1]] 
set_property PACKAGE_PIN D27 [get_ports HB_P[1]] 
set_property IOSTANDARD LVDS [get_ports HB_P[10]] 
set_property PACKAGE_PIN M25 [get_ports HB_P[10]] 
set_property IOSTANDARD LVDS [get_ports HB_P[11]] 
set_property PACKAGE_PIN L24 [get_ports HB_P[11]] 
set_property IOSTANDARD LVDS [get_ports HB_P[12]] 
set_property PACKAGE_PIN P25 [get_ports HB_P[12]] 
set_property IOSTANDARD LVDS [get_ports HB_P[13]] 
set_property PACKAGE_PIN P24 [get_ports HB_P[13]] 
set_property IOSTANDARD LVDS [get_ports HB_P[14]] 
set_property PACKAGE_PIN R27 [get_ports HB_P[14]] 
set_property IOSTANDARD LVDS [get_ports HB_P[15]] 
set_property PACKAGE_PIN T24 [get_ports HB_P[15]] 
set_property IOSTANDARD LVDS [get_ports HB_P[16]] 
set_property PACKAGE_PIN T26 [get_ports HB_P[16]] 
set_property IOSTANDARD LVDS [get_ports HB_P[17]] 
set_property PACKAGE_PIN K27 [get_ports HB_P[17]] 
set_property IOSTANDARD LVDS [get_ports HB_P[18]] 
set_property PACKAGE_PIN R31 [get_ports HB_P[18]] 
set_property IOSTANDARD LVDS [get_ports HB_P[19]] 
set_property PACKAGE_PIN L28 [get_ports HB_P[19]] 
set_property IOSTANDARD LVDS [get_ports HB_P[2]] 
set_property PACKAGE_PIN C27 [get_ports HB_P[2]] 
set_property IOSTANDARD LVDS [get_ports HB_P[20]] 
set_property PACKAGE_PIN N32 [get_ports HB_P[20]] 
set_property IOSTANDARD LVDS [get_ports HB_P[21]] 
set_property PACKAGE_PIN M27 [get_ports HB_P[21]] 
set_property IOSTANDARD LVDS [get_ports HB_P[3]] 
set_property PACKAGE_PIN C25 [get_ports HB_P[3]] 
set_property IOSTANDARD LVDS [get_ports HB_P[4]] 
set_property PACKAGE_PIN F28 [get_ports HB_P[4]] 
set_property IOSTANDARD LVDS [get_ports HB_P[5]] 
set_property PACKAGE_PIN G25 [get_ports HB_P[5]] 
set_property IOSTANDARD LVDS [get_ports HB_P[6]] 
set_property PACKAGE_PIN K26 [get_ports HB_P[6]] 
set_property IOSTANDARD LVDS [get_ports HB_P[7]] 
set_property PACKAGE_PIN D25 [get_ports HB_P[7]] 
set_property IOSTANDARD LVDS [get_ports HB_P[8]] 
set_property PACKAGE_PIN E26 [get_ports HB_P[8]] 
set_property IOSTANDARD LVDS [get_ports HB_P[9]] 
set_property PACKAGE_PIN H28 [get_ports HB_P[9]] 
set_property IOSTANDARD LVCMOS18 [get_ports IOFPGA_CSO] 
set_property PACKAGE_PIN AL19 [get_ports IOFPGA_CSO] 
set_property IOSTANDARD LVCMOS18 [get_ports IOFPGA_D[4]] 
set_property PACKAGE_PIN AM19 [get_ports IOFPGA_D[4]] 
set_property IOSTANDARD LVCMOS18 [get_ports IOFPGA_D[5]] 
set_property PACKAGE_PIN AM18 [get_ports IOFPGA_D[5]] 
set_property IOSTANDARD LVCMOS18 [get_ports IOFPGA_D[6]] 
set_property PACKAGE_PIN AN20 [get_ports IOFPGA_D[6]] 
set_property IOSTANDARD LVCMOS18 [get_ports IOFPGA_D[7]] 
set_property PACKAGE_PIN AP20 [get_ports IOFPGA_D[7]] 
set_property IOSTANDARD LVCMOS18 [get_ports IOFPGA_NRST] 
set_property PACKAGE_PIN AM12 [get_ports IOFPGA_NRST] 
set_property IOSTANDARD LVCMOS18 [get_ports IOFPGA_nSEL] 
set_property PACKAGE_PIN AW17 [get_ports IOFPGA_nSEL] 
set_property IOSTANDARD LVCMOS18 [get_ports IOFPGA_NSPIR] 
set_property PACKAGE_PIN AM13 [get_ports IOFPGA_NSPIR] 
set_property IOSTANDARD LVCMOS18 [get_ports IOFPGA_SYSWDT] 
set_property PACKAGE_PIN AJ12 [get_ports IOFPGA_SYSWDT] 
set_property IOSTANDARD LVDS [get_ports LA_N[0]] 
set_property PACKAGE_PIN E38 [get_ports LA_N[0]] 
set_property IOSTANDARD LVDS [get_ports LA_N[1]] 
set_property PACKAGE_PIN F36 [get_ports LA_N[1]] 
set_property IOSTANDARD LVDS [get_ports LA_N[10]] 
set_property PACKAGE_PIN A35 [get_ports LA_N[10]] 
set_property IOSTANDARD LVDS [get_ports LA_N[11]] 
set_property PACKAGE_PIN A36 [get_ports LA_N[11]] 
set_property IOSTANDARD LVDS [get_ports LA_N[12]] 
set_property PACKAGE_PIN B37 [get_ports LA_N[12]] 
set_property IOSTANDARD LVDS [get_ports LA_N[13]] 
set_property PACKAGE_PIN B32 [get_ports LA_N[13]] 
set_property IOSTANDARD LVDS [get_ports LA_N[14]] 
set_property PACKAGE_PIN D32 [get_ports LA_N[14]] 
set_property IOSTANDARD LVDS [get_ports LA_N[15]] 
set_property PACKAGE_PIN B30 [get_ports LA_N[15]] 
set_property IOSTANDARD LVDS [get_ports LA_N[16]] 
set_property PACKAGE_PIN A33 [get_ports LA_N[16]] 
set_property IOSTANDARD LVDS [get_ports LA_N[17]] 
set_property PACKAGE_PIN G32 [get_ports LA_N[17]] 
set_property IOSTANDARD LVDS [get_ports LA_N[18]] 
set_property PACKAGE_PIN G37 [get_ports LA_N[18]] 
set_property IOSTANDARD LVDS [get_ports LA_N[19]] 
set_property PACKAGE_PIN D31 [get_ports LA_N[19]] 
set_property IOSTANDARD LVDS [get_ports LA_N[2]] 
set_property PACKAGE_PIN D39 [get_ports LA_N[2]] 
set_property IOSTANDARD LVDS [get_ports LA_N[20]] 
set_property PACKAGE_PIN C29 [get_ports LA_N[20]] 
set_property IOSTANDARD LVDS [get_ports LA_N[21]] 
set_property PACKAGE_PIN E34 [get_ports LA_N[21]] 
set_property IOSTANDARD LVDS [get_ports LA_N[22]] 
set_property PACKAGE_PIN E33 [get_ports LA_N[22]] 
set_property IOSTANDARD LVDS [get_ports LA_N[23]] 
set_property PACKAGE_PIN E29 [get_ports LA_N[23]] 
set_property IOSTANDARD LVDS [get_ports LA_N[24]] 
set_property PACKAGE_PIN H37 [get_ports LA_N[24]] 
set_property IOSTANDARD LVDS [get_ports LA_N[25]] 
set_property PACKAGE_PIN H35 [get_ports LA_N[25]] 
set_property IOSTANDARD LVDS [get_ports LA_N[26]] 
set_property PACKAGE_PIN G35 [get_ports LA_N[26]] 
set_property IOSTANDARD LVDS [get_ports LA_N[27]] 
set_property PACKAGE_PIN G33 [get_ports LA_N[27]] 
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
set_property PACKAGE_PIN AH33 [get_ports MMB_DATA[8]] 
set_property IOSTANDARD LVCMOS18 [get_ports MMB_DATA[9]] 
set_property PACKAGE_PIN AJ36 [get_ports MMB_DATA[9]] 
set_property IOSTANDARD LVCMOS18 [get_ports MMB_DE] 
set_property PACKAGE_PIN AN35 [get_ports MMB_DE] 
set_property IOSTANDARD LVCMOS18 [get_ports MMB_HS] 
set_property PACKAGE_PIN AN36 [get_ports MMB_HS] 
set_property IOSTANDARD LVCMOS18 [get_ports MMB_IDCLK_R] 
set_property PACKAGE_PIN AP33 [get_ports MMB_IDCLK_R] 
set_property IOSTANDARD LVCMOS18 [get_ports MMB_SCK_R] 
set_property PACKAGE_PIN AP35 [get_ports MMB_SCK_R] 
set_property IOSTANDARD LVCMOS18 [get_ports MMB_SD[0]] 
set_property PACKAGE_PIN AR35 [get_ports MMB_SD[0]] 
set_property IOSTANDARD LVCMOS18 [get_ports MMB_SD[1]] 
set_property PACKAGE_PIN AP38 [get_ports MMB_SD[1]] 
set_property IOSTANDARD LVCMOS18 [get_ports MMB_SD[2]] 
set_property PACKAGE_PIN AP37 [get_ports MMB_SD[2]] 
set_property IOSTANDARD LVCMOS18 [get_ports MMB_SD[3]] 
set_property PACKAGE_PIN AP36 [get_ports MMB_SD[3]] 
set_property IOSTANDARD LVCMOS18 [get_ports MMB_VS] 
set_property PACKAGE_PIN AR37 [get_ports MMB_VS] 
set_property IOSTANDARD LVCMOS18 [get_ports MMB_WS] 
set_property PACKAGE_PIN AR38 [get_ports MMB_WS] 
set_property IOSTANDARD LVCMOS18 [get_ports OSCCLKA[0]] 
set_property PACKAGE_PIN AM33 [get_ports OSCCLKA[0]] 
set_property IOSTANDARD LVCMOS18 [get_ports OSCCLKA[1]] 
set_property PACKAGE_PIN AK34 [get_ports OSCCLKA[1]] 
set_property IOSTANDARD LVCMOS18 [get_ports OSCCLKA[2]] 
set_property PACKAGE_PIN AW23 [get_ports OSCCLKA[2]] 
set_property IOSTANDARD LVCMOS18 [get_ports OSCCLKA[3]] 
set_property PACKAGE_PIN AY24 [get_ports OSCCLKA[3]] 
set_property IOSTANDARD LVCMOS18 [get_ports OSCCLKA[4]] 
set_property PACKAGE_PIN AU19 [get_ports OSCCLKA[4]] 
set_property IOSTANDARD LVCMOS18 [get_ports OSCCLKA[5]] 
set_property PACKAGE_PIN H27 [get_ports OSCCLKA[5]] 
set_property IOSTANDARD LVCMOS12 [get_ports OSCCLKB[0]] 
set_property PACKAGE_PIN K21 [get_ports OSCCLKB[0]] 
set_property IOSTANDARD LVCMOS12 [get_ports OSCCLKB[1]] 
set_property PACKAGE_PIN K22 [get_ports OSCCLKB[1]] 
set_property IOSTANDARD LVCMOS18 [get_ports OSCCLKB[2]] 
set_property PACKAGE_PIN R14 [get_ports OSCCLKB[2]] 
set_property IOSTANDARD LVCMOS18 [get_ports OSCCLKB[3]] 
set_property PACKAGE_PIN C10 [get_ports OSCCLKB[3]] 
set_property IOSTANDARD LVCMOS18 [get_ports PB_IRQ] 
set_property PACKAGE_PIN AK14 [get_ports PB_IRQ] 
set_property IOSTANDARD DIFF_HSTL_I_18  [get_ports PCIE_CLKN] 
set_property PACKAGE_PIN W8 [get_ports PCIE_CLKN] 
set_property IOSTANDARD DIFF_HSTL_I_18  [get_ports PCIE_CLKP] 
set_property PACKAGE_PIN W9 [get_ports PCIE_CLKP] 
set_property IOSTANDARD LVCMOS18 [get_ports PCIE_nPERST] 
set_property PACKAGE_PIN C19 [get_ports PCIE_nPERST] 
set_property IOSTANDARD LVCMOS18 [get_ports PCIE_nPRSNT[0]] 
set_property PACKAGE_PIN A20 [get_ports PCIE_nPRSNT[0]] 
set_property IOSTANDARD LVCMOS18 [get_ports PCIE_nPRSNT[1]] 
set_property PACKAGE_PIN A19 [get_ports PCIE_nPRSNT[1]] 
set_property IOSTANDARD LVCMOS18 [get_ports PCIE_nWAKE] 
set_property PACKAGE_PIN C18 [get_ports PCIE_nWAKE] 
set_property IOSTANDARD DIFF_HSTL_I_18  [get_ports PCIE_PERN[0]] 
set_property PACKAGE_PIN Y1 [get_ports PCIE_PERN[0]] 
set_property IOSTANDARD DIFF_HSTL_I_18  [get_ports PCIE_PERN[1]] 
set_property PACKAGE_PIN W3 [get_ports PCIE_PERN[1]] 
set_property IOSTANDARD DIFF_HSTL_I_18  [get_ports PCIE_PERN[2]] 
set_property PACKAGE_PIN V1 [get_ports PCIE_PERN[2]] 
set_property IOSTANDARD DIFF_HSTL_I_18  [get_ports PCIE_PERN[3]] 
set_property PACKAGE_PIN U3 [get_ports PCIE_PERN[3]] 
set_property IOSTANDARD DIFF_HSTL_I_18  [get_ports PCIE_PERP[0]] 
set_property PACKAGE_PIN Y2 [get_ports PCIE_PERP[0]] 
set_property IOSTANDARD DIFF_HSTL_I_18  [get_ports PCIE_PERP[1]] 
set_property PACKAGE_PIN W4 [get_ports PCIE_PERP[1]] 
set_property IOSTANDARD DIFF_HSTL_I_18  [get_ports PCIE_PERP[2]] 
set_property PACKAGE_PIN V2 [get_ports PCIE_PERP[2]] 
set_property IOSTANDARD DIFF_HSTL_I_18  [get_ports PCIE_PERP[3]] 
set_property PACKAGE_PIN U4 [get_ports PCIE_PERP[3]] 
set_property IOSTANDARD DIFF_HSTL_I_18  [get_ports PCIE_PETN[0]] 
set_property PACKAGE_PIN V6 [get_ports PCIE_PETN[0]] 
set_property IOSTANDARD DIFF_HSTL_I_18  [get_ports PCIE_PETN[1]] 
set_property PACKAGE_PIN T6 [get_ports PCIE_PETN[1]] 
set_property IOSTANDARD DIFF_HSTL_I_18  [get_ports PCIE_PETN[2]] 
set_property PACKAGE_PIN P6 [get_ports PCIE_PETN[2]] 
set_property IOSTANDARD DIFF_HSTL_I_18  [get_ports PCIE_PETN[3]] 
set_property PACKAGE_PIN M6 [get_ports PCIE_PETN[3]] 
set_property IOSTANDARD DIFF_HSTL_I_18  [get_ports PCIE_PETP[0]] 
set_property PACKAGE_PIN V7 [get_ports PCIE_PETP[0]] 
set_property IOSTANDARD DIFF_HSTL_I_18  [get_ports PCIE_PETP[1]] 
set_property PACKAGE_PIN T7 [get_ports PCIE_PETP[1]] 
set_property IOSTANDARD DIFF_HSTL_I_18  [get_ports PCIE_PETP[2]] 
set_property PACKAGE_PIN P7 [get_ports PCIE_PETP[2]] 
set_property IOSTANDARD DIFF_HSTL_I_18  [get_ports PCIE_PETP[3]] 
set_property PACKAGE_PIN M7 [get_ports PCIE_PETP[3]] 
set_property IOSTANDARD LVCMOS18 [get_ports PEX_nFATAL] 
set_property PACKAGE_PIN C17 [get_ports PEX_nFATAL] 
set_property IOSTANDARD LVCMOS18 [get_ports PEX_nINTA] 
set_property PACKAGE_PIN B20 [get_ports PEX_nINTA] 
set_property IOSTANDARD LVCMOS18 [get_ports PEX_nPERST] 
set_property PACKAGE_PIN B18 [get_ports PEX_nPERST] 
set_property IOSTANDARD LVCMOS18 [get_ports QSPI_D[0]] 
set_property PACKAGE_PIN AA12 [get_ports QSPI_D[0]] 
set_property IOSTANDARD LVCMOS18 [get_ports QSPI_D[1]] 
set_property PACKAGE_PIN Y14 [get_ports QSPI_D[1]] 
set_property IOSTANDARD LVCMOS18 [get_ports QSPI_D[2]] 
set_property PACKAGE_PIN Y13 [get_ports QSPI_D[2]] 
set_property IOSTANDARD LVCMOS18 [get_ports QSPI_D[3]] 
set_property PACKAGE_PIN Y12 [get_ports QSPI_D[3]] 
set_property IOSTANDARD LVCMOS18 [get_ports QSPI_nCS] 
set_property PACKAGE_PIN AA14 [get_ports QSPI_nCS] 
set_property IOSTANDARD LVCMOS18 [get_ports QSPI_SCLK_R] 
set_property PACKAGE_PIN AA13 [get_ports QSPI_SCLK_R] 
set_property IOSTANDARD LVCMOS18 [get_ports REFCLK24] 
set_property PACKAGE_PIN BB9 [get_ports REFCLK24] 
set_property IOSTANDARD LVCMOS18 [get_ports SH_ADC_CK_R] 
set_property PACKAGE_PIN T15 [get_ports SH_ADC_CK_R] 
set_property IOSTANDARD LVCMOS18 [get_ports SH_ADC_CS] 
set_property PACKAGE_PIN T16 [get_ports SH_ADC_CS] 
set_property IOSTANDARD LVCMOS18 [get_ports SH_ADC_DI] 
set_property PACKAGE_PIN U16 [get_ports SH_ADC_DI] 
set_property IOSTANDARD LVCMOS18 [get_ports SH_ADC_DO] 
set_property PACKAGE_PIN U15 [get_ports SH_ADC_DO] 
set_property IOSTANDARD LVCMOS18 [get_ports SH_CLKI] 
set_property PACKAGE_PIN U13 [get_ports SH_CLKI] 
set_property IOSTANDARD LVCMOS18 [get_ports SH_CLKO_R] 
set_property PACKAGE_PIN T14 [get_ports SH_CLKO_R] 
set_property IOSTANDARD LVCMOS18 [get_ports SH_nRST] 
set_property PACKAGE_PIN C9 [get_ports SH_nRST] 
set_property IOSTANDARD LVDS [get_ports SH_RSVDN[0]] 
set_property PACKAGE_PIN AU22 [get_ports SH_RSVDN[0]] 
set_property IOSTANDARD LVDS [get_ports SH_RSVDN[1]] 
set_property PACKAGE_PIN AV23 [get_ports SH_RSVDN[1]] 
set_property IOSTANDARD LVDS [get_ports SH_RSVDP[0]] 
set_property PACKAGE_PIN AT22 [get_ports SH_RSVDP[0]] 
set_property IOSTANDARD LVDS [get_ports SH_RSVDP[1]] 
set_property PACKAGE_PIN AU23 [get_ports SH_RSVDP[1]] 
set_property IOSTANDARD LVCMOS18 [get_ports SH0_IO[0]] 
set_property PACKAGE_PIN M15 [get_ports SH0_IO[0]] 
set_property IOSTANDARD LVCMOS18 [get_ports SH0_IO[1]] 
set_property PACKAGE_PIN M13 [get_ports SH0_IO[1]] 
set_property IOSTANDARD LVCMOS18 [get_ports SH0_IO[10]] 
set_property PACKAGE_PIN K13 [get_ports SH0_IO[10]] 
set_property IOSTANDARD LVCMOS18 [get_ports SH0_IO[11]] 
set_property PACKAGE_PIN K12 [get_ports SH0_IO[11]] 
set_property IOSTANDARD LVCMOS18 [get_ports SH0_IO[12]] 
set_property PACKAGE_PIN K11 [get_ports SH0_IO[12]] 
set_property IOSTANDARD LVCMOS18 [get_ports SH0_IO[13]] 
set_property PACKAGE_PIN J14 [get_ports SH0_IO[13]] 
set_property IOSTANDARD LVCMOS18 [get_ports SH0_IO[14]] 
set_property PACKAGE_PIN J12 [get_ports SH0_IO[14]] 
set_property IOSTANDARD LVCMOS18 [get_ports SH0_IO[15]] 
set_property PACKAGE_PIN J11 [get_ports SH0_IO[15]] 
set_property IOSTANDARD LVCMOS18 [get_ports SH0_IO[2]] 
set_property PACKAGE_PIN M12 [get_ports SH0_IO[2]] 
set_property IOSTANDARD LVCMOS18 [get_ports SH0_IO[3]] 
set_property PACKAGE_PIN M11 [get_ports SH0_IO[3]] 
set_property IOSTANDARD LVCMOS18 [get_ports SH0_IO[4]] 
set_property PACKAGE_PIN L15 [get_ports SH0_IO[4]] 
set_property IOSTANDARD LVCMOS18 [get_ports SH0_IO[5]] 
set_property PACKAGE_PIN L14 [get_ports SH0_IO[5]] 
set_property IOSTANDARD LVCMOS18 [get_ports SH0_IO[6]] 
set_property PACKAGE_PIN L13 [get_ports SH0_IO[6]] 
set_property IOSTANDARD LVCMOS18 [get_ports SH0_IO[7]] 
set_property PACKAGE_PIN L11 [get_ports SH0_IO[7]] 
set_property IOSTANDARD LVCMOS18 [get_ports SH0_IO[8]] 
set_property PACKAGE_PIN K14 [get_ports SH0_IO[8]] 
set_property IOSTANDARD LVCMOS18 [get_ports SH0_IO[9]] 
set_property PACKAGE_PIN V13 [get_ports SH0_IO[9]] 
set_property IOSTANDARD LVCMOS18 [get_ports SH0_nEN[0]] 
set_property PACKAGE_PIN F13 [get_ports SH0_nEN[0]] 
set_property IOSTANDARD LVCMOS18 [get_ports SH0_nEN[1]] 
set_property PACKAGE_PIN E14 [get_ports SH0_nEN[1]] 
set_property IOSTANDARD LVCMOS18 [get_ports SH0_nEN[10]] 
set_property PACKAGE_PIN G13 [get_ports SH0_nEN[10]] 
set_property IOSTANDARD LVCMOS18 [get_ports SH0_nEN[11]] 
set_property PACKAGE_PIN G15 [get_ports SH0_nEN[11]] 
set_property IOSTANDARD LVCMOS18 [get_ports SH0_nEN[12]] 
set_property PACKAGE_PIN H12 [get_ports SH0_nEN[12]] 
set_property IOSTANDARD LVCMOS18 [get_ports SH0_nEN[13]] 
set_property PACKAGE_PIN H13 [get_ports SH0_nEN[13]] 
set_property IOSTANDARD LVCMOS18 [get_ports SH0_nEN[14]] 
set_property PACKAGE_PIN H14 [get_ports SH0_nEN[14]] 
set_property IOSTANDARD LVCMOS18 [get_ports SH0_nEN[15]] 
set_property PACKAGE_PIN H15 [get_ports SH0_nEN[15]] 
set_property IOSTANDARD LVCMOS18 [get_ports SH0_nEN[2]] 
set_property PACKAGE_PIN F9 [get_ports SH0_nEN[2]] 
set_property IOSTANDARD LVCMOS18 [get_ports SH0_nEN[3]] 
set_property PACKAGE_PIN F10 [get_ports SH0_nEN[3]] 
set_property IOSTANDARD LVCMOS18 [get_ports SH0_nEN[4]] 
set_property PACKAGE_PIN F11 [get_ports SH0_nEN[4]] 
set_property IOSTANDARD LVCMOS18 [get_ports SH0_nEN[5]] 
set_property PACKAGE_PIN F14 [get_ports SH0_nEN[5]] 
set_property IOSTANDARD LVCMOS18 [get_ports SH0_nEN[6]] 
set_property PACKAGE_PIN F15 [get_ports SH0_nEN[6]] 
set_property IOSTANDARD LVCMOS18 [get_ports SH0_nEN[7]] 
set_property PACKAGE_PIN G10 [get_ports SH0_nEN[7]] 
set_property IOSTANDARD LVCMOS18 [get_ports SH0_nEN[8]] 
set_property PACKAGE_PIN G11 [get_ports SH0_nEN[8]] 
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
set_property PACKAGE_PIN F19 [get_ports SMBM_nE[4]] 
set_property IOSTANDARD LVCMOS18 [get_ports SMBM_nOE] 
set_property PACKAGE_PIN H18 [get_ports SMBM_nOE] 
set_property IOSTANDARD LVCMOS18 [get_ports SMBM_nWAIT] 
set_property PACKAGE_PIN H17 [get_ports SMBM_nWAIT] 
set_property IOSTANDARD LVCMOS18 [get_ports SMBM_nWE] 
set_property PACKAGE_PIN J17 [get_ports SMBM_nWE] 
set_property IOSTANDARD LVCMOS18 [get_ports UART_RX_F[0]] 
set_property PACKAGE_PIN AV8 [get_ports UART_RX_F[0]] 
set_property IOSTANDARD LVCMOS18 [get_ports UART_RX_F[1]] 
set_property PACKAGE_PIN AV9 [get_ports UART_RX_F[1]] 
set_property IOSTANDARD LVCMOS18 [get_ports UART_RX_F[2]] 
set_property PACKAGE_PIN BB7 [get_ports UART_RX_F[2]] 
set_property IOSTANDARD LVCMOS18 [get_ports UART_RX_F[3]] 
set_property PACKAGE_PIN BA7 [get_ports UART_RX_F[3]] 
set_property IOSTANDARD LVCMOS18 [get_ports UART_TX_F[0]] 
set_property PACKAGE_PIN AW7 [get_ports UART_TX_F[0]] 
set_property IOSTANDARD LVCMOS18 [get_ports UART_TX_F[1]] 
set_property PACKAGE_PIN AW8 [get_ports UART_TX_F[1]] 
set_property IOSTANDARD LVCMOS18 [get_ports UART_TX_F[2]] 
set_property PACKAGE_PIN AY7 [get_ports UART_TX_F[2]] 
set_property IOSTANDARD LVCMOS18 [get_ports UART_TX_F[3]] 
set_property PACKAGE_PIN AY8 [get_ports UART_TX_F[3]] 
set_property IOSTANDARD LVCMOS18 [get_ports USD_CLK_R] 
set_property PACKAGE_PIN T13 [get_ports USD_CLK_R] 
set_property IOSTANDARD LVCMOS18 [get_ports USD_CMD] 
set_property PACKAGE_PIN W12 [get_ports USD_CMD] 
set_property IOSTANDARD LVCMOS18 [get_ports USD_DAT[0]] 
set_property PACKAGE_PIN V16 [get_ports USD_DAT[0]] 
set_property IOSTANDARD LVCMOS18 [get_ports USD_DAT[1]] 
set_property PACKAGE_PIN V15 [get_ports USD_DAT[1]] 
set_property IOSTANDARD LVCMOS18 [get_ports USD_DAT[2]] 
set_property PACKAGE_PIN W14 [get_ports USD_DAT[2]] 
set_property IOSTANDARD LVCMOS18 [get_ports USD_DAT[3]] 
set_property PACKAGE_PIN V14 [get_ports USD_DAT[3]] 
set_property IOSTANDARD LVCMOS18 [get_ports USD_NCD] 
set_property PACKAGE_PIN V12 [get_ports USD_NCD] 
set_property IOSTANDARD LVCMOS18 [get_ports USER_nLED[0]] 
set_property PACKAGE_PIN B7 [get_ports USER_nLED[0]] 
set_property IOSTANDARD LVCMOS18 [get_ports USER_nLED[1]] 
set_property PACKAGE_PIN B8 [get_ports USER_nLED[1]] 
set_property IOSTANDARD LVCMOS18 [get_ports USER_nLED[2]] 
set_property PACKAGE_PIN B10 [get_ports USER_nLED[2]] 
set_property IOSTANDARD LVCMOS18 [get_ports USER_nLED[3]] 
set_property PACKAGE_PIN B11 [get_ports USER_nLED[3]] 
set_property IOSTANDARD LVCMOS18 [get_ports USER_nLED[4]] 
set_property PACKAGE_PIN B12 [get_ports USER_nLED[4]] 
set_property IOSTANDARD LVCMOS18 [get_ports USER_nLED[5]] 
set_property PACKAGE_PIN B13 [get_ports USER_nLED[5]] 
set_property IOSTANDARD LVCMOS18 [get_ports USER_nLED[6]] 
set_property PACKAGE_PIN B15 [get_ports USER_nLED[6]] 
set_property IOSTANDARD LVCMOS18 [get_ports USER_nLED[7]] 
set_property PACKAGE_PIN B16 [get_ports USER_nLED[7]] 
set_property IOSTANDARD LVCMOS18 [get_ports USER_nLED[8]] 
set_property PACKAGE_PIN C7 [get_ports USER_nLED[8]] 
set_property IOSTANDARD LVCMOS18 [get_ports USER_nLED[9]] 
set_property PACKAGE_PIN C8 [get_ports USER_nLED[9]] 
set_property IOSTANDARD LVCMOS18 [get_ports USER_nPB[0]] 
set_property PACKAGE_PIN B17 [get_ports USER_nPB[0]] 
set_property IOSTANDARD LVCMOS18 [get_ports USER_nPB[1]] 
set_property PACKAGE_PIN A18 [get_ports USER_nPB[1]] 
set_property IOSTANDARD LVCMOS12 [get_ports USER_SW[0]] 
set_property PACKAGE_PIN K23 [get_ports USER_SW[0]] 
set_property IOSTANDARD LVCMOS12 [get_ports USER_SW[1]] 
set_property PACKAGE_PIN B22 [get_ports USER_SW[1]] 
set_property IOSTANDARD LVCMOS12 [get_ports USER_SW[2]] 
set_property PACKAGE_PIN B21 [get_ports USER_SW[2]] 
set_property IOSTANDARD LVCMOS12 [get_ports USER_SW[3]] 
set_property PACKAGE_PIN J20 [get_ports USER_SW[3]] 
set_property IOSTANDARD LVCMOS12 [get_ports USER_SW[4]] 
set_property PACKAGE_PIN H20 [get_ports USER_SW[4]] 
set_property IOSTANDARD LVCMOS12 [get_ports USER_SW[5]] 
set_property PACKAGE_PIN D21 [get_ports USER_SW[5]] 
set_property IOSTANDARD LVCMOS12 [get_ports USER_SW[6]] 
set_property PACKAGE_PIN L23 [get_ports USER_SW[6]] 
set_property IOSTANDARD LVCMOS12 [get_ports USER_SW[7]] 
set_property PACKAGE_PIN D22 [get_ports USER_SW[7]] 
set_property IOSTANDARD LVCMOS18 [get_ports WDOG_RREQ] 
set_property PACKAGE_PIN AK13 [get_ports WDOG_RREQ] 


set_property PULLUP true [get_ports QSPI_D[0]]
set_property PULLUP true [get_ports QSPI_D[1]]
set_property PULLUP true [get_ports QSPI_D[2]]
set_property PULLUP true [get_ports QSPI_D[3]]

# set_property IOSTANDARD SSTL12_DCI [get_ports "c0_ddr4_bg[0]"]
# set_property OUTPUT_IMPEDANCE RDRV_40_40 [get_ports "c0_ddr4_bg[0]"]

set_property CONFIG_VOLTAGE 3.3 [current_design]
set_property CFGBVS VCCO [current_design]
set_property BITSTREAM.CONFIG.UNUSEDPIN Pullnone [current_design]
set_property BITSTREAM.CONFIG.PERSIST Yes [current_design]
set_property BITSTREAM.STARTUP.MATCH_CYCLE Auto [current_design]
set_property BITSTREAM.GENERAL.COMPRESS True [current_design]
set_property CONFIG_MODE S_SELECTMAP [current_design]
