SoC-Labs/MegaSoC-Project/(commit log)

2024-11-20 V1.1 bootrom verilog and updating FPGA flows
2025-07-16 Initial ASIC flow for megasoc
2025-07-30 Add expansion subsystem DMA integration and test
2025-09-23 Fix DMA350 generation and ASIC backend updates
    [mps4_pins.csv]
2026-06-25 chore: bump megasoc_tech submodule pointer for sdio driver fixes
    Picks up sdiodrv.c FPGA-validated fixes and the sdio_tests sim
    makefile overrides committed in the submodule (megasoc_tech 063f3f3).
2026-06-25 sim: correct BEHAV clock model frequency error
    megasoc_clock_ctrl.v (simulation/BEHAV variant only): clock_cpu period
    was 0.5ns (1GHz), 10x too fast relative to the 100MHz base that
    sdio.v's non-SERDES clock divider math assumes (see sdio.v parameter
    comment: "limited to 50MHz from a 100MHz clock"). Now 5ns (100MHz).
    FPGA/ and ASIC/ clock_ctrl variants are unaffected -- neither uses
    this file.
    [megasoc_clock_ctrl.v]
2026-06-25 verif: Synopsys VC-VIP-SOC eMMC/SD UVM testbench
    Card-only UVM environment (svt_emmc_card_agent, SD card mode). The
    real ZipCPU SDIO RTL is the host; the VIP is the card model. The
    existing BEHAV flow (top_BEHAV.flist, mdl_sdio.v) is completely
    unaffected -- this is a separate, independent verification path
    selected via top_VIP.flist.
    Result: Total SDIO errors = 0 | UVM_ERROR = 0 | UVM_FATAL = 0
    TC1-TC14 all pass. See sdio_synopsys_vip_verification_report.md.
    [card_cfg.sv, sdio_base_test.sv, sdio_card_env.sv, sdio_vip_tc3_test.sv, sim_done_if.sv, tb_top.sv]
2026-06-29 build: bump megasoc_tech for ZipCPU -> soclabs/sdio-controller submodule swap
    Picks up megasoc_tech a001468, which repoints logical/sdspi at
    soclabs/sdio-controller instead of the upstream ZipCPU fork.
    megasoc_tb.flist: removed the 5 logical/sdspi/bench/verilog/mdl_*.v
    references -- sdio-controller does not carry bench/ models. The BEHAV
    flow's SDIO verification path is retired in favour of the Synopsys
    VC-VIP-SOC UVM testbench (top_VIP.flist / uvm_vip_tb.flist), which is
    unaffected by this change.
2026-06-29 fix: retire mdl_sdio.v card model from megasoc_tb.sv, add VIP convenience targets
    megasoc_tb.sv instantiated mdl_sdio as u_sd_card_model, but its module
    definition was already dropped from megasoc_tb.flist when logical/sdspi
    was swapped to soclabs/sdio-controller (no bench/ models). This caused
    a UPF/elaboration "cell not found" error for u_sd_card_model. Removed
    the instantiation; the SDIO pullups are kept since they're independent
    of the card model.
    flows/makefile.simulate: added compile_vip/run_vip targets wrapping the
    Synopsys VC-VIP-SOC compile/run commands (top_VIP.flist, UVM defines,
    +UVM_TESTNAME), so running the VIP flow no longer requires retyping the
    full command by hand.
    env/de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
    [megasoc_tb.sv]
2026-07-07 Point submodule URLs at github.com/SoC-Labs after GitLab migration
    Repos were renamed in the move: megasoc_tech -> MegaSoC-Tech,
    soctools_flow -> SoCTools-Flow, asic_flow -> ASIC-Flow.
2026-09-07 fix(flow): compile_vip/run_vip discard FLIST_INCLUDES and fail UPF elaboration
    The recursive $(MAKE) call in compile_vip/run_vip inherited an
    already-resolved FLIST_INCLUDES from the parent process, then re-ran the
    same += accumulation on top of it, doubling every flist entry and hitting
    VCS's 10-error MPD cap before real design files were even reached. An
    earlier attempt blanked FLIST_INCLUDES on the command line to stop the
    doubling, but a command-line assignment is immutable for the rest of that
    child process, so it silently discarded required content (CA53 clock-gate
    cell models, ROM_wrapper.sv/bootrom.v) that megasoc_tech_wrapper.sv always
    instantiates. Fix: pass through the parent's re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
2026-09-16 fix(megasoc): tie off EXP_IRQs to complete the non-INC_EXP expansion boundary (#1)
    With INC_EXP undefined, expansion_subsystem_wrapper is never instantiated,
    so EXP_IRQs[7:0] was left with no driver -- unlike every other
    EXP_M_AXI/EXP_S_AXI signal in the same tie-off branch, it had been missed.
    The undriven wire read X/Z into the CPU_IRQS concatenation
    (megasoc_tech_wrapper.sv:321, bits [85:78], GIC SPIs 110-117), corrupting
    any GICD_ISPENDRn/GICD_SPISRn bank read covering that range and hanging
    software comparisons against the resulting partially-X word (bits
    108-109/118-119 in the same bank also disturbed).
    Fix: assign EXP_IRQs = 8'h0 in the non-INC_EXP branch, matching the
    "nonexistent d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
    [megasoc_system.sv]
2026-09-16 fix(flow): stop -assert nopostproc from silently discarding assertion coverage under COVERAGE=1 (#2)
2026-09-17 fix(flow): define SDFRONTEND_SPLIT_TRISTATE for compile_vip/run_vip
    sdio-controller's sdfrontend.v renamed its port-selection macro from
    VERILATOR to SDFRONTEND_SPLIT_TRISTATE, to stop a project-wide
    +define+VERILATOR from also flipping unrelated ifdef VERILATOR code in
    other vendored IP (the same Arm CA53/UPF leakage problem the previous
    commit removed +define+VERILATOR to fix). Without this define,
    megasoc_chip.v's sdfrontend instantiation loses its io_cmd_tristate/
    i_dat/etc. ports (Error-[UPIMI-E] Undefined port), since that module's
    plain `inout` form is now the default.
    Must be a command-line define, not a local `define inside
    megasoc_chip.v: sdfrontend.v compiles before megasoc_chip.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
2026-09-20 fix(sdio): bump megasoc_tech to resolve UPIMI compile_vip failure (#3)
    Advances the megasoc_tech submodule pointer to 291758c, which bumps the
    nested sdspi submodule to 315fe08 (SDFRONTEND_SPLIT_TRISTATE rename) and
    widens the SDIO driver's DMA buffer address into sd_dma_addr_lo/hi
    (SDIO_M_AXI is 44 bits, wider than a 32-bit pointer). main's
    flows/makefile.simulate already defines SDFRONTEND_SPLIT_TRISTATE for the
    VIP flow (7e7ba6b); this pointer bump was the only remaining piece.
    Verified with a full make compile_vip run: zero Error-/UPIMI hits, simv
    built cleanly.
2026-09-21 fix(megasoc): resolve EXP_M AXI tie-off protocol violations causing NIC400 hangs (#4)
    * fix(megasoc): gate EXP_M_AXI.BVALID on accepted-AW count instead of tying it permanently high
    In the non-INC_EXP expansion-bus tie-off (megasoc_system.sv), the EXP_M
    AXI write-response valid signal (BVALID) was hardwired to 1, so the bus
    reported a completed write response even when zero write requests had
    been accepted -- an AXI4 protocol violation (a response with no matching
    request) that fires on every boot. This spurious "phantom" response
    happens before any real write is ever issued, which desyncs the NIC400
    interconnect's outstanding-write-ID tracking and is the likely root
    cause of a separately o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
    [megasoc_system.sv]
2026-09-21 fix(flow): use SDFRONTEND_SPLIT_TRISTATE instead of stale VERILATOR define
    sdfrontend.v's port-selection macro was renamed from VERILATOR to
    SDFRONTEND_SPLIT_TRISTATE (see 7e7ba6b, which updated the VIP flow's
    defines but missed the plain compile/compile_vcs path). The stale
    VERILATOR define here no longer selects sdfrontend's split-tristate
    port form, so megasoc_chip.v's instantiation lost its io_cmd_tristate/
    i_dat/etc. ports (Error-[UPIMI-E] Undefined port on `make compile`).
    Verified with 'make compile SIMULATOR=vcs': 491/491 modules compiled,
    simv linked, Verdi KDB elaboration 0 errors/0 warnings.
2026-10-15 LPDDR4 DRAM integration: build option, top-level plumbing and test bench (#5)
    * feat(lpddr4): build switch and top-level plumbing for the LPDDR4 subsystem
    - env: SOCLABS_LPDDR4_DIR / LPDDR4_PROJECT_DIR for the lpddr4_subsystem
    submodule inside megasoc_tech.
    - megasoc.config: Synopsys LPDDR4 controller/PHY install paths (?=).
    - makefile: INC_LPDDR4 ?= no. When yes: add megasoc_tech_LPDDR4.flist,
    the subsystem's design defines (read from its flist, since flist
    +define+ lines are not passed through) and +define+INC_LPDDR4; export
    the IP paths.
    - megasoc_system, megasoc_chip, glib pads: DDR_CLK and LPDDR4_* ports
    passed through (the PHY has its own I/O cells).
    - megasoc_tb: 400 MHz DD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
2026-10-16 LPDDR4 low-power handshake monitors in megasoc_tb (#6)
    * feat(tb): LPDDR4 low-power handshake monitors
    INC_LPDDR4 builds only: LPDDR4_MON lines for the two LPDDR4 low-power
    interfaces (request, answer, and whether the answer was an accept or a
    refusal), the controller's activity on each channel, and the DRAM PPU's
    request; LPDDR4_WAVES=yes also dumps the two Q-channel adapters and the
    DRAM power-domain block. Bump megasoc_tech to the DRAM power domain.
    * chore: point megasoc_tech at the DRAM power domain (fbd1d64)
2026-10-22 fpga(haps-sx): HAPS-SX VU19P bring-up contribution and single-file flash image in the software flow (#7)
    * fpga(haps-sx): add the HAPS-SX VU19P bring-up contribution
    Everything needed to reproduce the MegaSoC bring-up on the Synopsys HAPS-SX
    VU19P and the state reached on 21 October 2026: the stock boot sequence runs
    end to end on the board (boot ROM, SRAM, both UARTs, GIC-400 interrupts, PPU
    power sequencing, the on-board W25Q32FW programmed over UART and booted in QPI
    mode through the XIP window, both CPU caches enabled); 7 of the 11 SoC Labs
    tests pass from RAM, from an in-FPGA flash emulator and from the physical flash.
    fpga/targets/haps_sx/bringup/
    rtl/ FPGA top, debug logg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
2026-10-30 fpga(haps-sx): DDR4 SODIMM on the NIC-400 DRAM port and the L2 data RAM integration fix (builds 58-59) (#8)
    * fpga(haps-sx): DDR4 SODIMM on the DRAM port, L2 data RAM integration fix, builds 55-59
    - rtl: haps_ddr4_bridge.sv (DRAM_AXI 64-bit @ 20 MHz -> AXI clock converter -> 64->512 width
    converter -> Xilinx DDR4 IP, rank bit tied low, converters held in reset until calibration);
    haps_top.sv with the DDR4 ports, reference clock and LED_G1 = calibrated
    - constraints: haps_top_ddr4_impl.xdc (123 SODIMM pins, DCI cascade, asynchronous clock groups)
    - ddr4/: MGSOC-34 step 1 (IP generation as the vendor's HAPS-SX design, example-design build,
    pin XDC from the SoC Labs CSV, JTAG calibration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
2026-11-01 SDIO VIP bench on LPDDR4 + full boot from SD card into DRAM (#9)
    * feat(sdio-vip): run the SDIO VIP bench on LPDDR4; add the full boot test
    - tb_top.sv: LPDDR4 device model under INC_LPDDR4 (as in megasoc_tb.sv);
    sim_done also latched from extio_eof, the path that fires under
    CORTEX_A53+USE_TARMAC.
    - sdio_base_test.sv: end the run 50 us after the firmware finishes; the
    LPDDR4 model's UVM agents keep run-phase objections open.
    - makefile, makefile.simulate, uvm_vip_tb.flist: INC_LPDDR4 builds use
    simulate/sim_lpddr4; the SDIO VIP flow gets the LPDDR4 defines and takes
    the eMMC VIP from the folder shared with the LPDDR4 model
    (make build_megasoc_vip_models), so one SVT common libr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
2026-11-06 megasoc_tech: NIC-400 ETH/DMA ports and 10-bit AXI ID (#10)
    Bump megasoc_tech to 884f370, which adds the ETH_M, DMA_M, ETH_S and
    DMA_S ports to nic400_megasoc_main (tied to idle until the Ethernet and
    DMA-350 RTL are integrated) and widens the NIC global AXI ID from 9 to
    10 bits, with the SIE-300 ROM/RAM controllers regenerated to match.
    After checkout, in megasoc_tech run make build_nic400 and
    make build_sie300_sram_ctrl.
    Docs:
    docs/eth_dma_nic400_changes.md NIC-400 change sheet for the new ports
2026-11-06 Ethernet: INC_ETH build option, MII pins and test bench (#11)
    Bring the Ethernet subsystem (megasoc_tech, ethmac_subsystem_apb) up to
    the chip and into both test benches. INC_ETH defaults to no; the default
    build is unchanged.
    - megasoc_tech: bump to the Ethernet integration commit.
    - makefile: INC_ETH ?= no. yes adds +define+INC_ETH +define+ETH_WISHBONE_B3
    and megasoc_tech_ETH.flist, in the normal flow and in the SDIO VIP flow
    (compile_vip replaces DEFINES_VC, so the defines also go into
    VIP_DEFINES_VC).
    - env/dependency_env.sh: SOCLABS_ETHMAC_AHB_DIR, ETHMAC_IP_DIR,
    HA1588_IP_DIR (OpenCores sources used by the submodule).
    - 18 MII/MDIO pins through megasoc_system, megasoc_chip and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
2026-11-09 DMA-350: INC_DMA build option and megasoc_tech bump (#12)
    - makefile: INC_DMA ?= no. With INC_DMA=yes, add +define+INC_DMA and
    megasoc_tech_DMA.flist (also in the SDIO VIP flow); compiles stop
    early with a clear message if the DMA-350 has not been generated
    (make build_dma350 in megasoc_tech)
    - megasoc_tech: DMA-350 memory-to-memory integration (wrapper,
    interrupts GIC 129-133, dma350.h, 4 tests) and the DRAM simulation
    model WRAP burst fix
    Tested: 4 DMA tests with INC_DMA; hello_world and nic_decerr_tests in
    the default build; SDIO VIP regression; INC_DMA+INC_ETH compile with
    hello_world and dma350_irq_tests.
2026-11-09 megasoc_tech: point at the merged DMA-350 commit (#13)
    PR #12 recorded megasoc_tech 290ca19, which was only on the megasoc_tech
    feature branch (now deleted). Point at ef74ed4, the squash-merged commit
    on megasoc_tech main (identical tree).
2026-11-11 LPDDR4: use controller generated with a 10-bit AXI ID (#14)
    The NIC-400 drives a 10-bit AXI ID and the Ethernet and DMA-350 ports set
    bit 9. The previous controller had 9-bit ID ports, so bit 9 was dropped and
    DMA reads to DRAM came back with the wrong ID (CPU stall). Point at a new
    copy of the controller generated with a 10-bit ID; the original 9-bit copy
    is untouched for other projects.
    Tested with INC_DMA=yes INC_LPDDR4=yes: lpddr4_dram_tests and
    dma350_m2m_tests (all 24 cases, including 6 DRAM cases) pass.
2026-11-12 megasoc_tech: ROM/SRAM PPU warm-reset fix; bootrom: stale image guard (#16)
    Moves megasoc_tech to f76c23c (SoC-Labs/MegaSoC-Tech#17). A SW or
    watchdog reset now also resets the ROM and SRAM PPUs, so a domain left
    OFF with dynamic wake disabled no longer hangs the boot at the reset
    vector. Adds the ROM/SRAM PPU warm-reset tests and the Boot ROM tests.
    flows/makefile.software: the bootrom rule stops if the ROM image is
    older than the bootloader ELF (for example a bootloader.hex directory
    left by an older two-region build) instead of building bootrom.v from
    a stale image. It compares against the newer of the two ELF locations,
    prints the image path, both timestamps and the bootrom.v date, and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
2026-11-12 docs(datasheet): Security subsection under the address map: no TrustZone partitioning (MBT-68) (#17)
    States the MBT-68 decision of 10 Nov 2026 where readers look for the
    address map: every NIC-400 slave interface is configured Secure, so all
    transactions inside the interconnect are Secure and no region is
    Secure-only; the GIC-400 sees every access as Secure and interrupts are
    handled through its Secure register view in Group 0. Points at
    megasoc_tech/socrates (configuration of record) and MBT-68 for the
    rationale and the configuration that would enable TrustZone.
    The tracked Sphinx output under docs/build and the datasheet PDF are not
    regenerated; the source parses with docutils without war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
2026-11-13 megasoc_tech: peripheral default slave and APB slots C-F (BUG-43) (#18)
    Moves megasoc_tech from f76c23c to c9a16e5 (SoC-Labs/MegaSoC-Tech#20),
    which also brings in #18 and #19:
    - #20 (BUG-43): unmapped peripheral addresses (0x4003_0000-0x5FFF_FFFF,
    and 0x4100_0000 without INC_LPDDR4) and APB slots C-F
    (0x4000_C000-0x4000_FFFF) now answer with an error, which the A53
    takes as an external abort. They used to complete OKAY with read data 0
    and writes were dropped. Also adds nic_window_edge_tests,
    adp_target_matrix_tests and the SDIO_M -> EXP_M read/write tests.
    - #19 (MBT-68): NIC-400 configuration XML and README document that
    TrustZone partitioning is not used. No RTL change.
    - #1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
